toasterllc/MDCBoard/NextPCB-Order/NextPCB-Package-FedEx-Label.pdf

SHIP DATE: 13JUL23

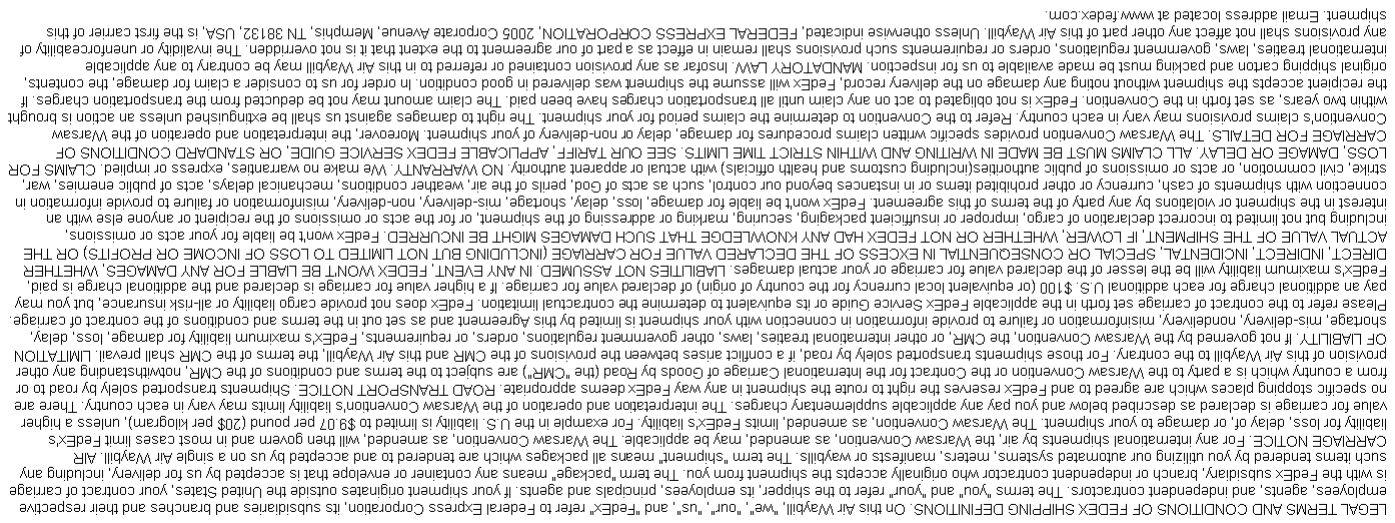
[picture p1: figure]

TO

(CN)

TRK#

ACTWGT: 0.33 KG

DIMS: 16x25x13 CM

REF:

INV:

PO: DEPT:

ORIGIN ID:ZSMA

0430

### (808) 990-3519 DAVID KECK

1200 FRANKLIN MALL

1279

### SANTA CLARA, CA 95050 US SIGN: DAVID KECK

CAD: 258250449/INET4535

BILL SENDER

AES X20230710678266

XIE LIJIA

NEXTPCB

5TH FLOOR,BLOCK A,BUILDING 2,ZONE B

KEGU INDUSTRIAL PARK

### 26 JIAN'AN ROAD

DONGGUAN 523846

8613413077079

# C4 DAXA

7727 2663 9725

PM
INTL CONN PLUS
ETD
523846

## -CN DGM
