toasterllc/MDCBoard/NextPCB-Order/Diodes-Orientation.jpg

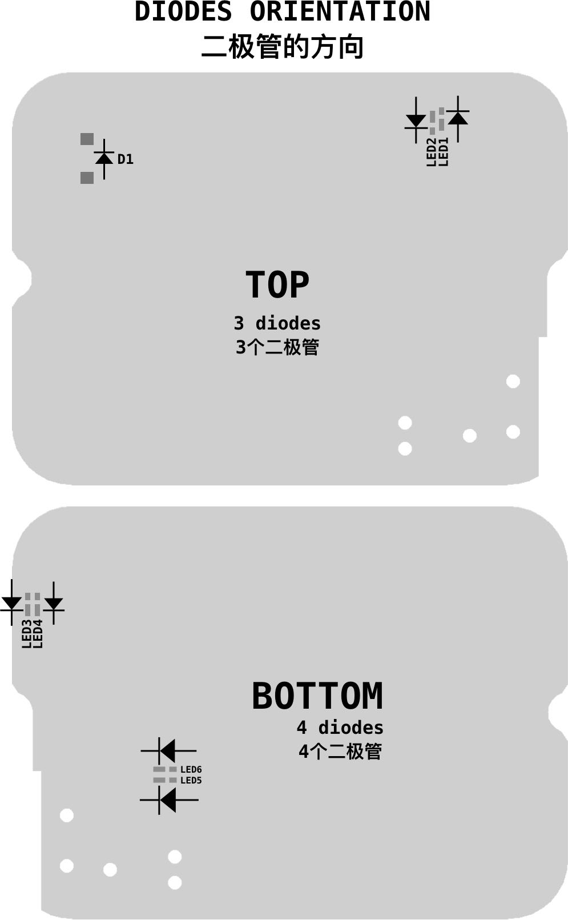
NextPCB-Order/Diodes-Orientation.jpg
