toasterllc/MDCBoard/NextPCB-Order/NextPCB-FedEx-Label.png

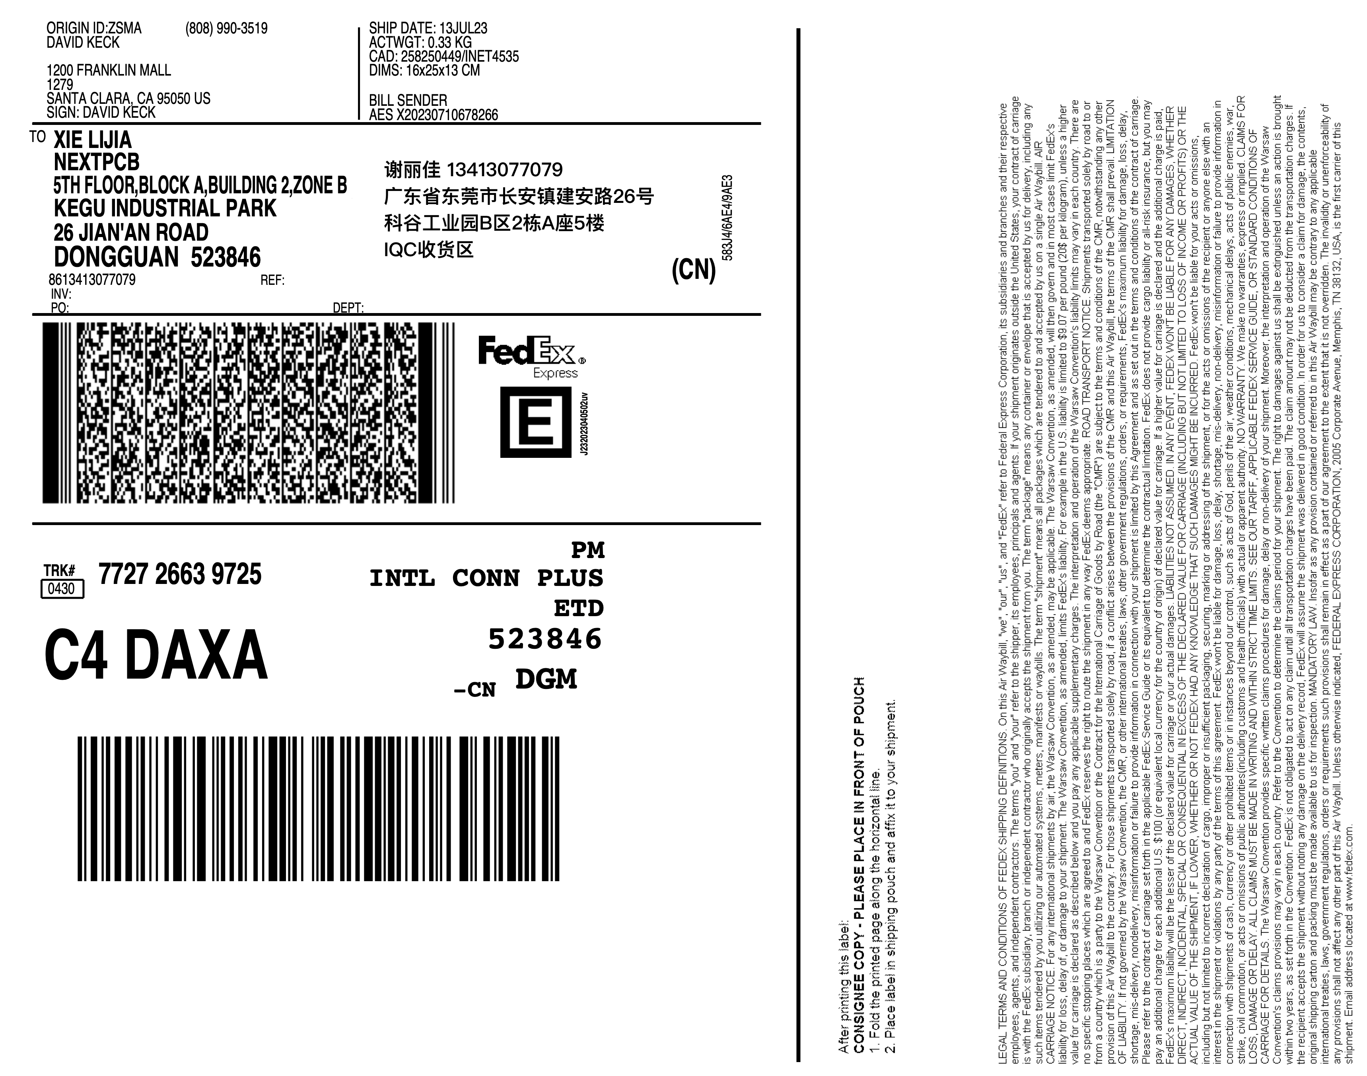
NextPCB-Order/NextPCB-FedEx-Label.png
