toasterllc/MDCBoard/NextPCB-Order/NextPCB-New-Parts.png

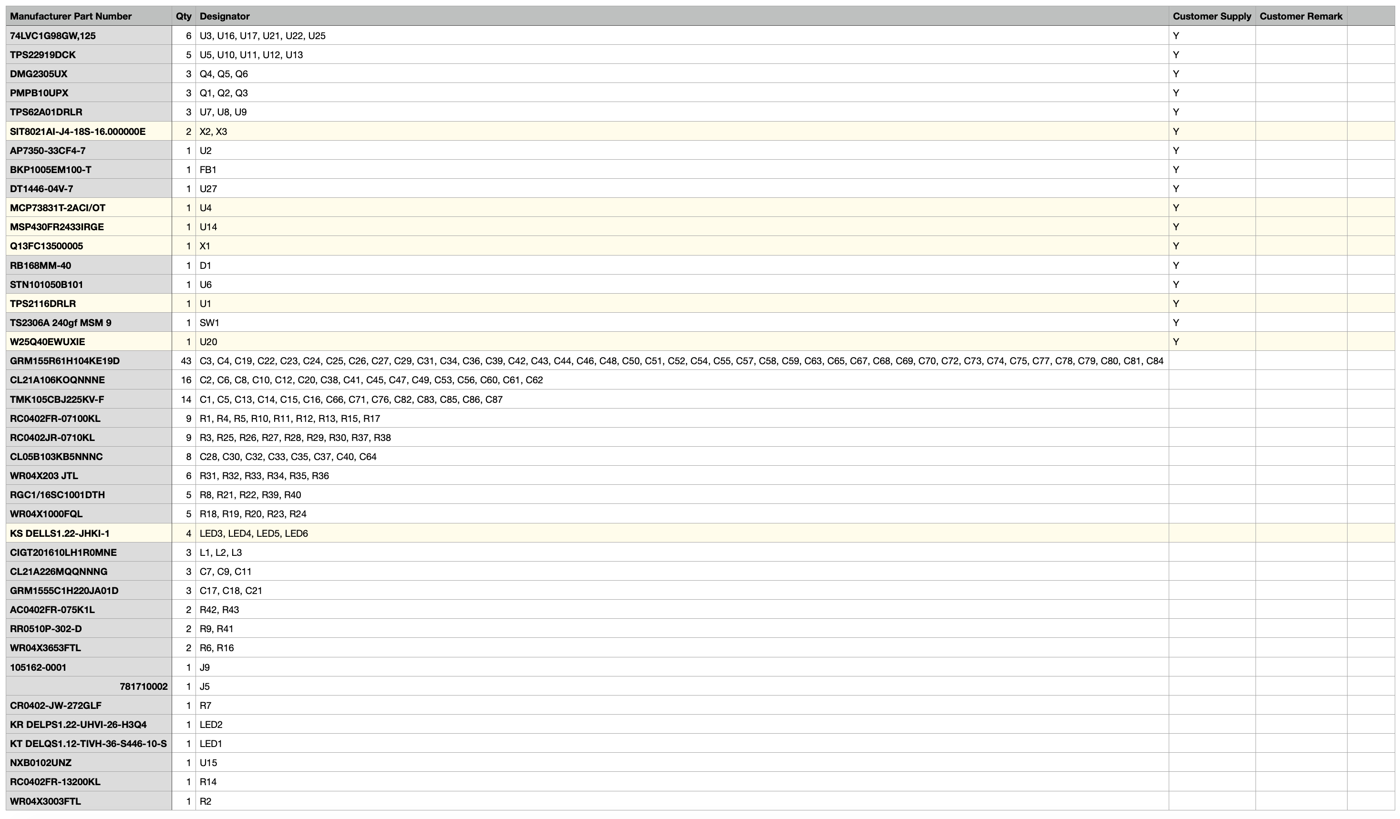
NextPCB-Order/NextPCB-New-Parts.png
