toasterllc/MDCBoard/NextPCB-Order/NextPCB-Package-FedEx-Label.png

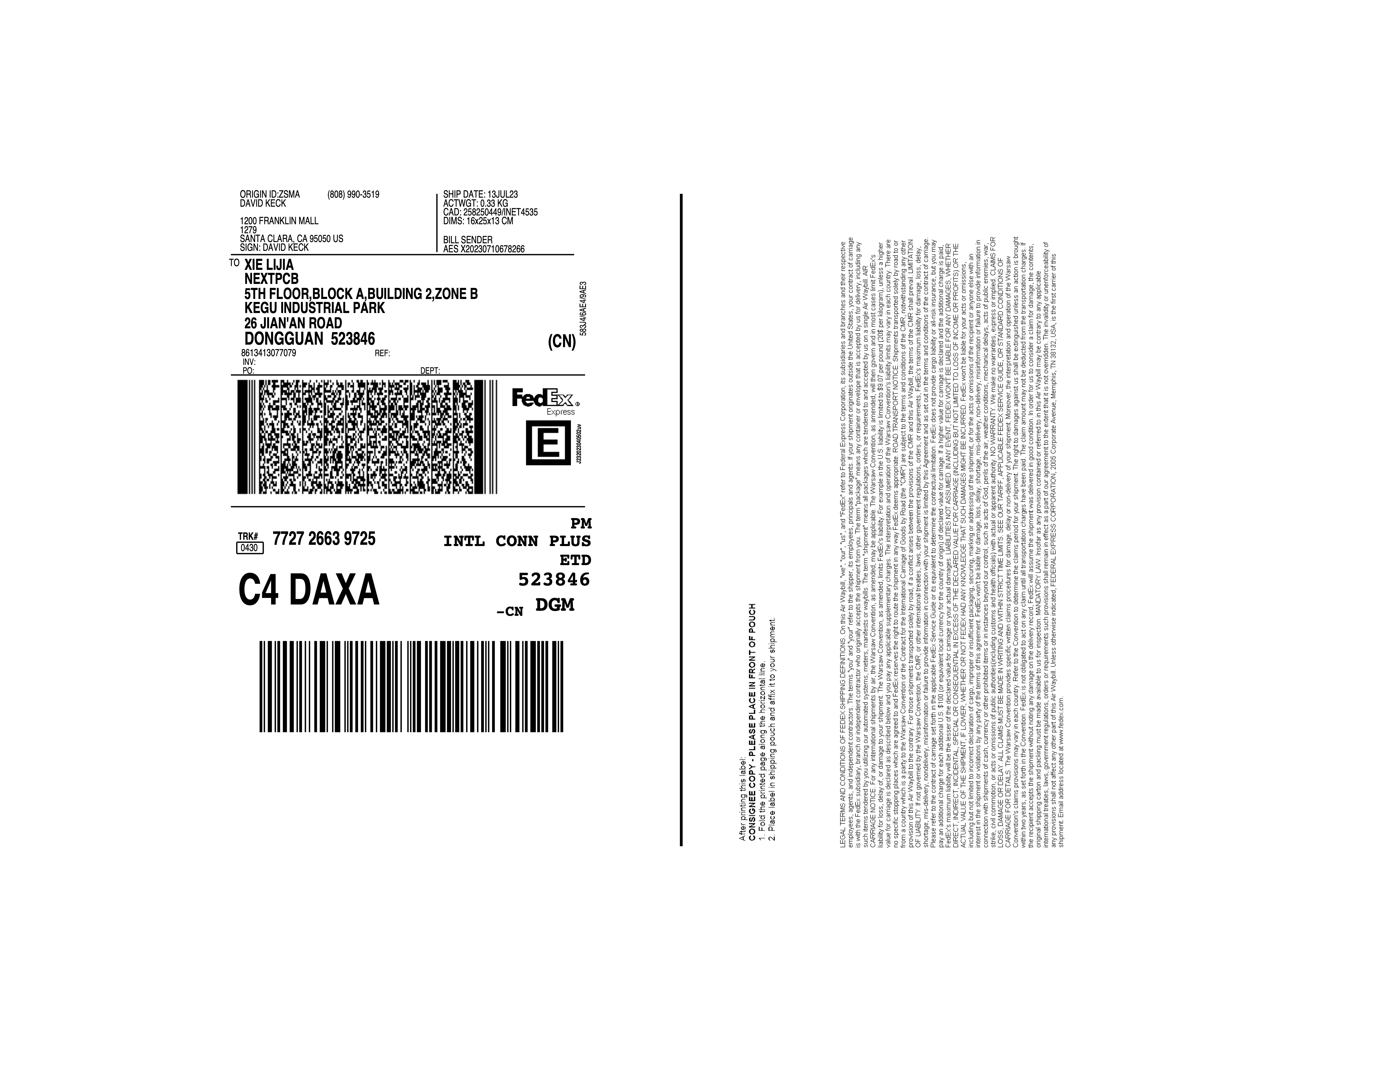
NextPCB-Order/NextPCB-Package-FedEx-Label.png
