toasterllc/MDCBoard/Schematic.pdf

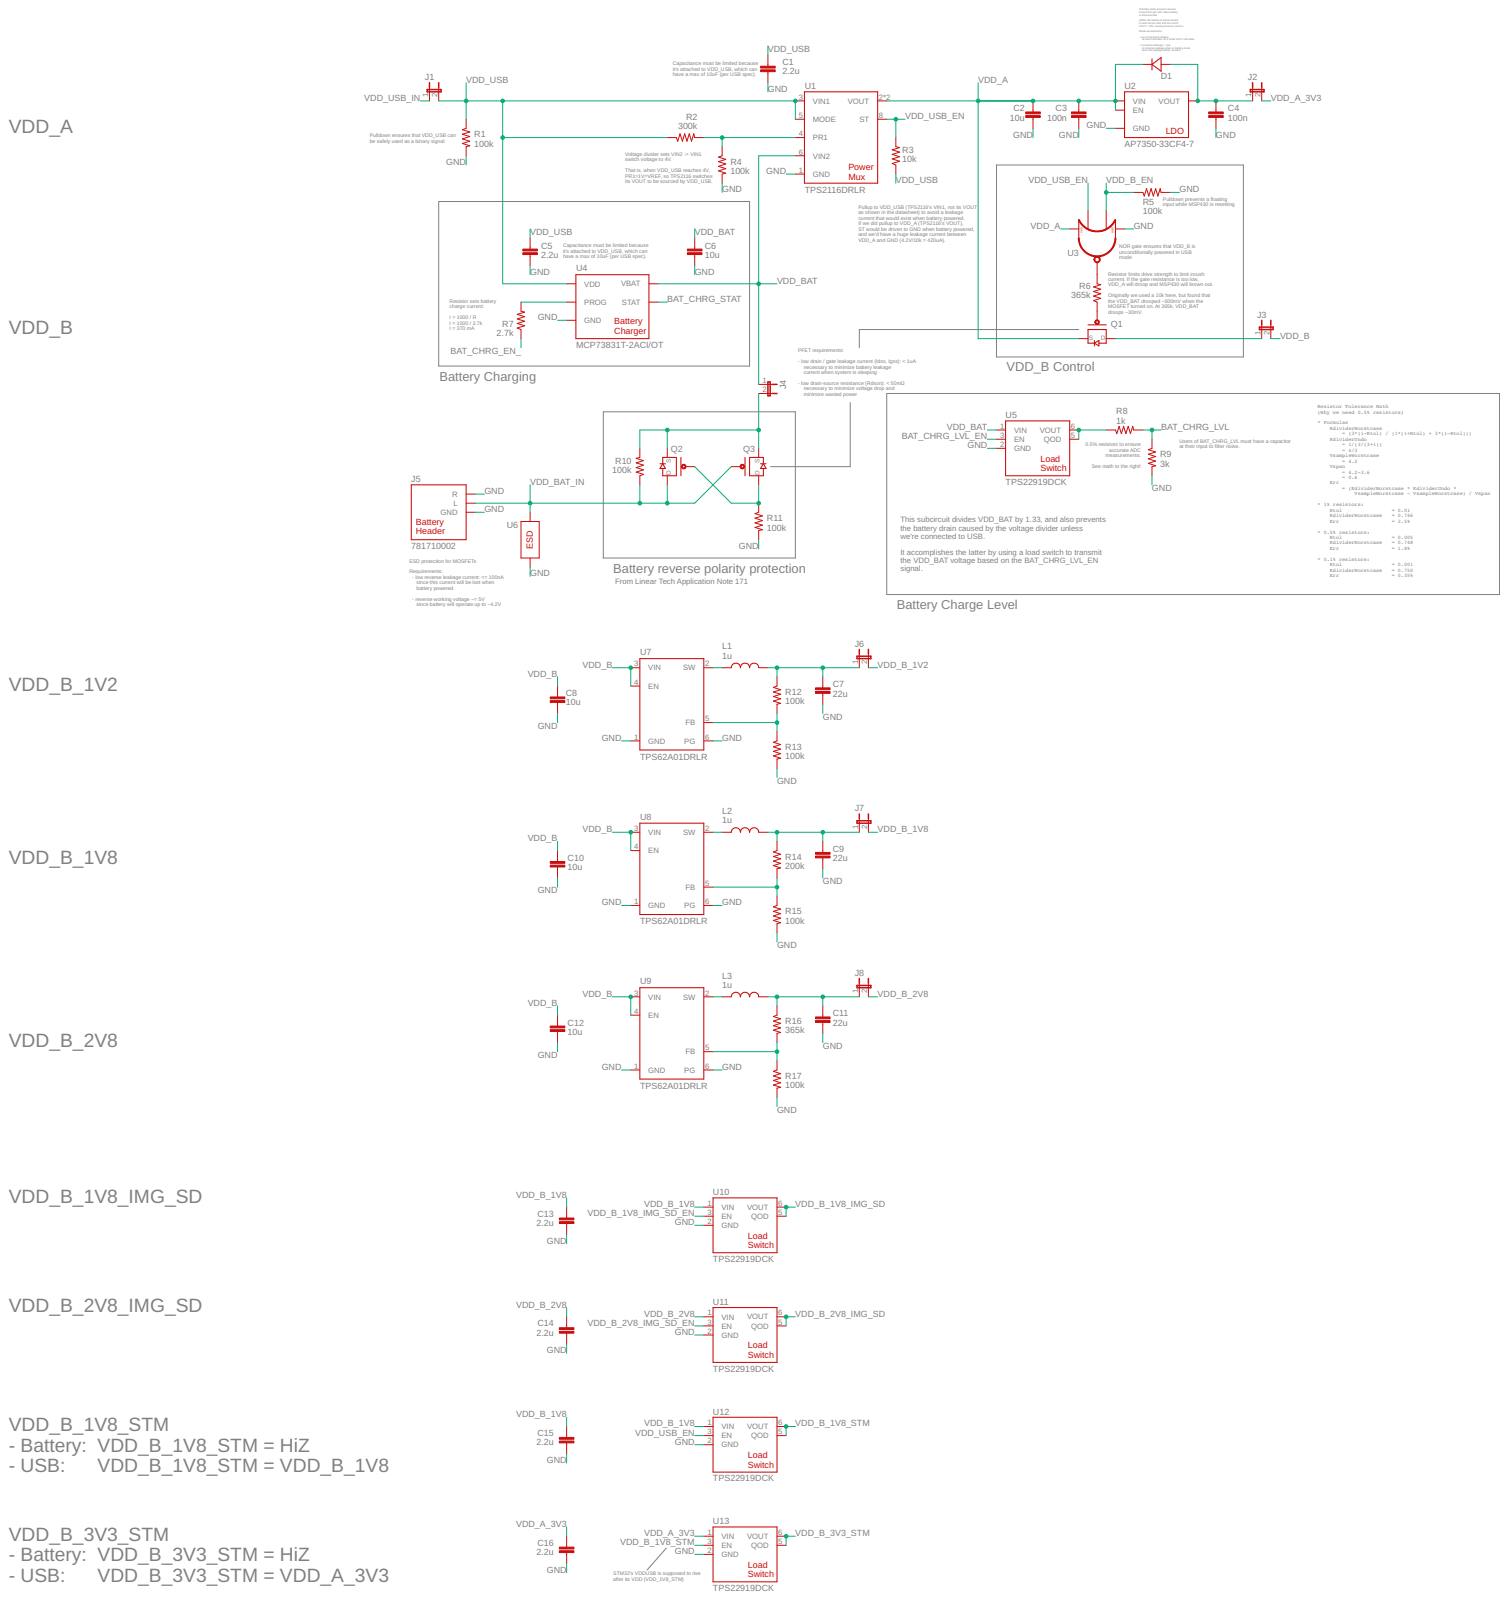
[picture p6: page 1]

Schottky diode prevents reverse
current through LDO when battery
is disconnected. (When the battery is disconnected,

it could be the case that the LDO's VOUT > VIN, causing reverse current.) Diode requirements: - Low Vf (forward voltage) so that it activates on a small VOUT-VIN delta

- Ir (reverse leakage) < 1µA
to minimize leakage when in battery-mode, since this leakage will be constant

Capacitance must be limited because
it's attached to VDD_USB, which can
have a max of 10uF (per USB spec).

Pulldown ensures that VDD_USB can
be safely used as a binary signal

Voltage divider sets VIN2 -> VIN1
switch voltage to 4V. That is, when VDD_USB reaches 4V, PR1=1V=VREF, so TPS2116 switches

its VOUT to be sourced by VDD_USB.

Pullup to VDD_USB (TPS2116's VIN1, not its VOUT
as shown in the datasheet) to avoid a leakage
current that would exist when battery powered.
If we did pullup to VDD_A (TPS2116's VOUT), ST would be driven to GND when battery powered, and we'd have a huge leakage current between VDD_A and GND (4.2V/10k = 420uA).

input while MSP430 is resetting

NOR gate ensures that VDD_B is unconditionally powered in USB mode

Resistor limits drive strength to limit inrush
current. If the gate resistance is too low, VDD_A will droop and MSP430 will brown out. Originally we used a 10k here, but found that

the VDD_BAT drooped ~500mV when the MOSFET turned on. At 365k, VDD_BAT
droops ~30mV.

PFET requirements: - low drain / gate leakage current (Idss, Igss): < 1uA

necessary to minimize battery leakage
current when system is sleeping
- low drain-source resistance (Rdson): < 50mΩ

(Why we need 0.5% resistors)

0.5% resistors to ensure
accurate ADC measurements. See math to the right!

Users of BAT_CHRG_LVL must have a capacitor at their input to filter noise.

This subcircuit divides VDD_BAT by 1.33, and also prevents
the battery drain caused by the voltage divider unless we're connected to USB.

It accomplishes the latter by using a load switch to transmit
the VDD_BAT voltage based on the BAT_CHRG_LVL_EN

signal. ESD protection for MOSFETs Requirements: - low reverse leakage current: <= 100nA

From Linear Tech Application Note 171 Battery reverse polarity protection

since this current will be lost when
battery powered
- reverse working voltage ~= 5V
since battery will operate up to ~4.2V

STM32's VDDUSB is supposed to rise
after its VDD (VDD_1V8_STM)

22p

22p | 22p
100n | 10u
100n | 100n

100n

From "MSP430TM 32-kHz Crystal Oscillators", section "Effective Load Capacitance": Crystal capacitor values are calculated using: C_L = (C + C_para) / 2 Where: C_L = load capacitance from crystal datasheet C = capacitor value to solve for C_para = parasitic capacitance of MSP pin + trace C_para = 2pF (MSP capacitance per pin) + 1 pF (estimated trace capacitance) = 3 pF C_L = 12.5 pF (from crystal datasheet) Therefore, C = 22 pF | Use NP0 dialectric capacitors to minimize

capacitance variation due to temperature and DC bias

MSP_RST_: MSP430 has an internal 20k-50k pullup on MSP_RST_, so we don't add an

external one to save a part. MSP_RST_: The MSP430 datasheet recommends a 1nF capacitor on MSP_RST_, but we don't use

that value anywhere else, so we're opting for a much smaller 22pF. (Note that we can't use a

larger value because it interferes with Spy-bi-wire comms.) Since the recommended 1nF capacitor is for noise suppression, we should be able to get away with a smaller capacitor, and it hasn't caused issues so far.

Use TXB0102's VCCB for our VDD_A because the datasheet says: "VCCA must not exceed VCCB"

Filtering capacitor to filter noise from high-impedance BAT_CHRG_LVL signal.

C21

C17 | C18 C19 | C20 | X1
C23 | C24

C22

## TEST/SBWTCK

2 | RST_/NMI/SBWTDIO
1 | DVCC
24 | DVSS

# 18*3 U14POWER MSP430FR2433IRGE

## PA.0/P1.0/UCB0STE/TA0CLK/A0/VEREF+

7 | | PA.1/P1.1/UCB0CLK/TA0.1/A1
8 | PA.2/P1.2/UCB0SIMO/UCB0SDA/TA0.2/A2/VEREF- 9 | PA.3/P1.3/UCB0SOMI/UCB0SCL/MCLK/A3
10 | | PA.4/P1.4/UCA0TXD/UCA0SIMO/TA1.2/TCK/A4/VREF+
3 | | PA.5/P1.5/UCA0RXD/UCA0SOMI/TA1.1/TMS/A5
4 | | PA.6/P1.6/UCA0CLK/TA1CLK/TDI/TCLK/A6
5 | | PA.7/P1.7/UCA0STE/SMCLK/TDO/A7
6

# U14PORT1 MSP430FR2433IRGE

## PA.8/P2.0/XOUT

21 | | PA.9/P2.1/XIN
22 | | PA.A/P2.2/ACLK
11 | | PA.B/P2.3
13 | | PA.C/P2.4/UCA1CLK
15 | PA.D/P2.5/UCA1RXD/UCA1SOMI 16 | PA.E/P2.6/UCA1TXD/UCA1SIMO
17 | | PA.F/P2.7
19

# U14PORT2 MSP430FR2433IRGE

## PB.0/P3.0

12 | PB.1/P3.1/UCA1STE
14 | PB.2/P3.2

# 20 U14PORT3 MSP430FR2433IRGE

B1 | A1 OE VCCA GND
B2 | A2

## VCCB

# Level Shifter NXB0102UNZ

U15

# VDD_A_3V3

# VDD_A_3V3

# VDD_A_3V3

# VDD_A_3V3 GND

GND | GND GND
GND GND | GND

# GND

GND MSP_TEST MSP_RST_ | MSP_RST_

# ICE_MSP_SPI_DATA_X

# ICE_MSP_SPI_DATA_X

# ICE_MSP_SPI_CLK_X

# ICE_MSP_SPI_CLK_X

# VDD_B_1V8 VDD_B_1V8

# VDD_B_1V8

MSP_XIN MSP_XOUT

# VDD_B_EN

# VDD_B_1V8_IMG_SD_EN

# ICE_MSP_SPI_CLK

# ICE_MSP_SPI_DATA

BAT_CHRG_LVL BAT_CHRG_LVL | BUTTON_SIGNAL_ MOTION_SIGNAL VDD_B_2V8_IMG_SD_EN | MOTION_EN_ MSP_STM_I2C_SDA MSP_STM_I2C_SCL | BAT_CHRG_LVL_EN

# VDD_B_3V3_STM

# LED_SIGNAL

LED_SEL Port 1 | Port 2 | Port 3

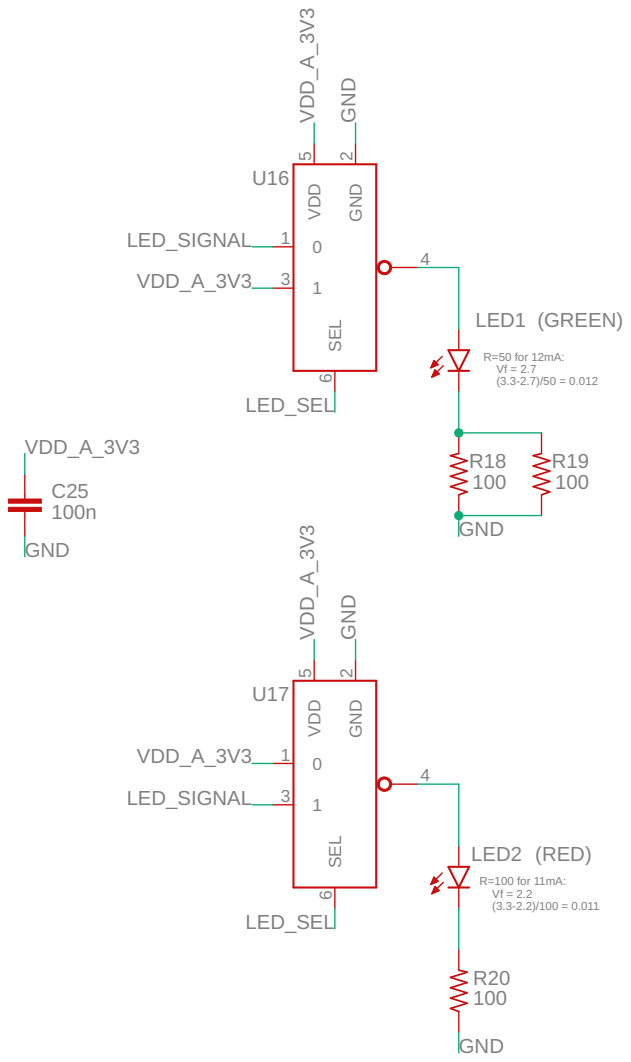
[picture p7: page 3]

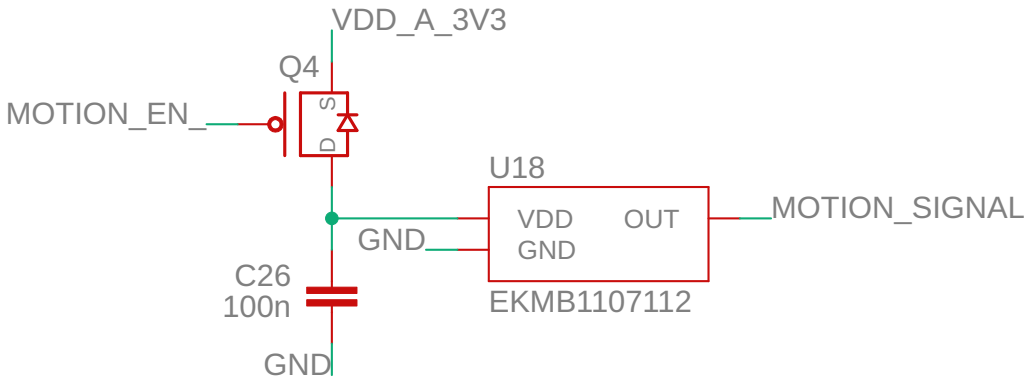
[picture p8: page 5]

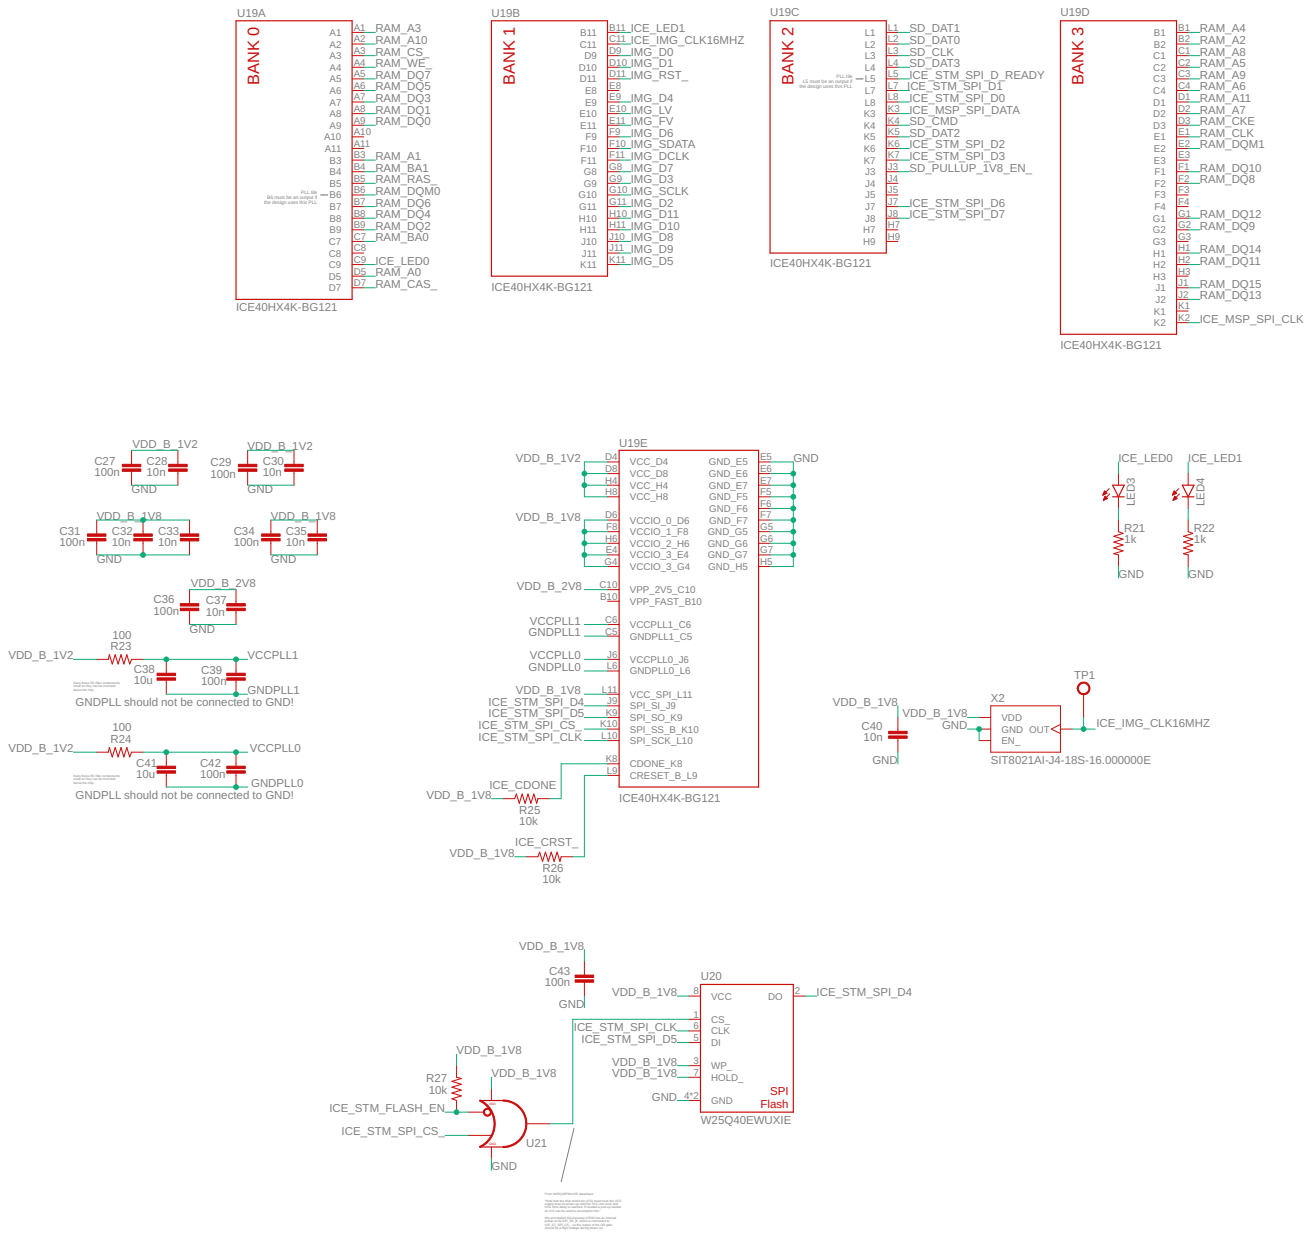
[picture p9: page 6]

L5 must be an output if
the design uses this PLL

PLL tile B6 must be an output if

Keep these RC filter components
small so they can be mounted
below the chip.
GNDPLL should not be connected to GND!

From W25Q40EWUXIE datasheet: "Note that the chip select pin (/CS) must track the VCC

supply level at power-up until the VCC-min level and
tVSL time delay is reached. If needed a pull-up resister on /CS can be used to accomplish this." We accomplish this because ICE40 has an internal pullup on its SPI_SS_B, which is connected to

ICE_ST_SPI_CS_, so the output of the OR gate
should be a high voltage during power up.

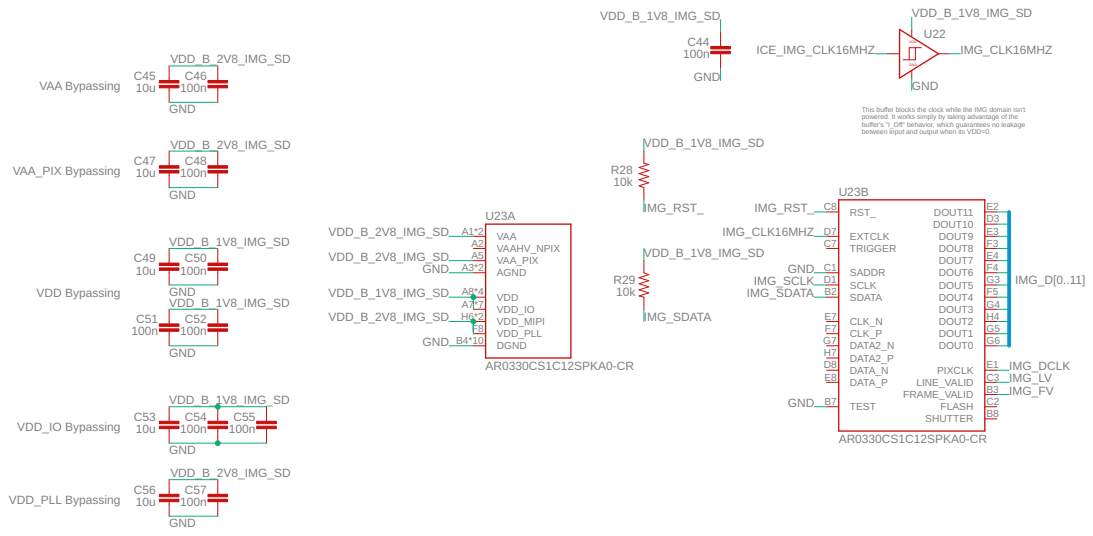
[picture p10: page 7]

This buffer blocks the clock while the IMG domain isn't powered. It works simply by taking advantage of the

buffer's "I_Off" behavior, which guarantees no leakage
between input and output when its VDD=0.

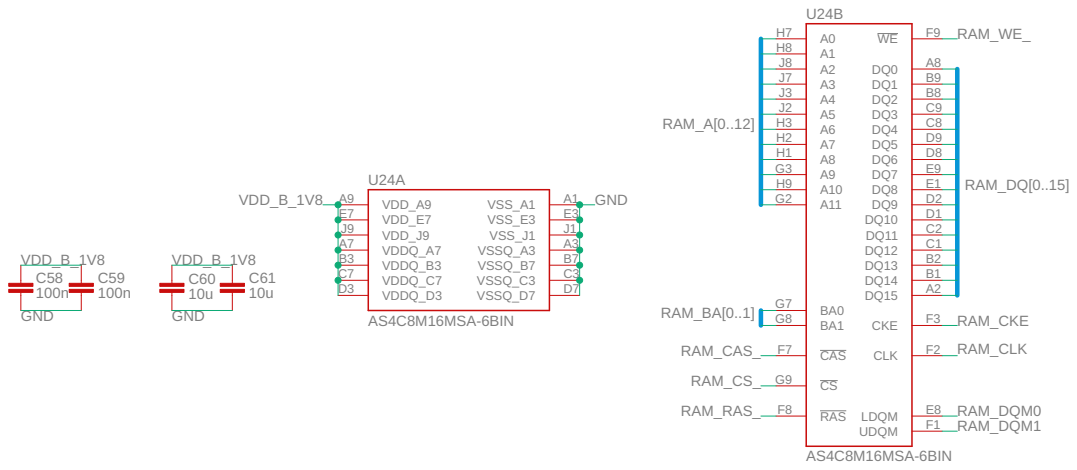
[picture p11: page 8]

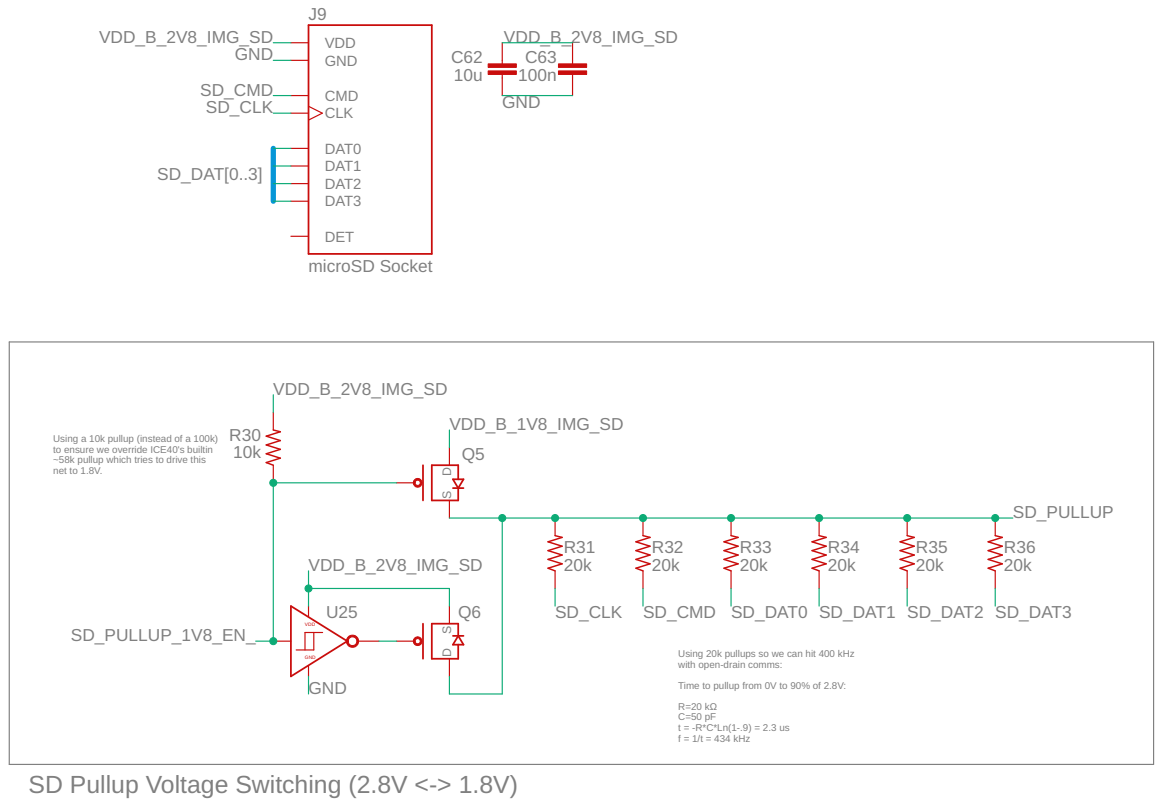
[picture p12: page 9]

Using a 10k pullup (instead of a 100k)
to ensure we override ICE40's builtin ~58k pullup which tries to drive this net to 1.8V.

Using 20k pullups so we can hit 400 kHz with open-drain comms: Time to pullup from 0V to 90% of 2.8V: R=20 kΩ

f = 1/t = 434 kHz SD Pullup Voltage Switching (2.8V <-> 1.8V)

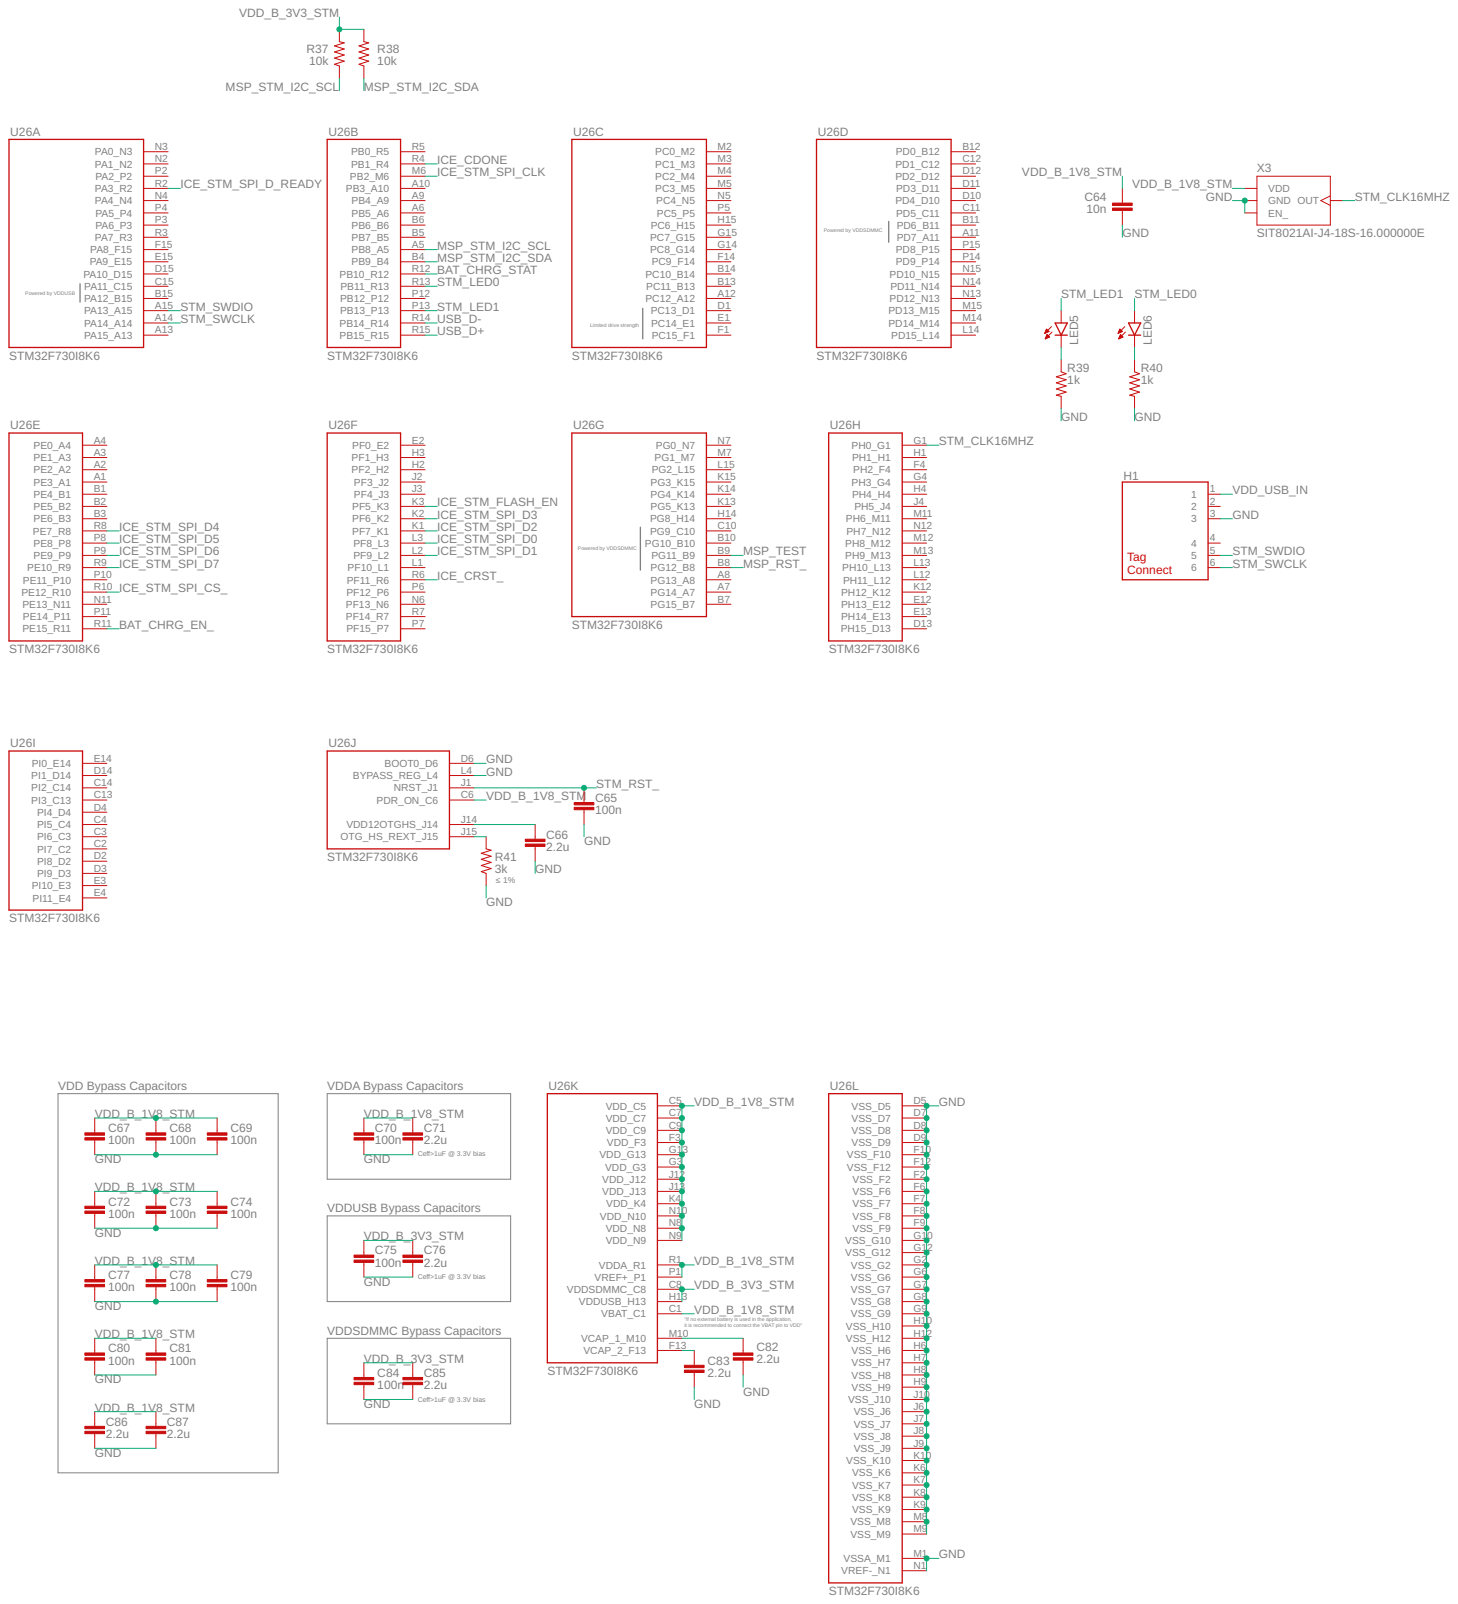
[picture p13: page 10]

it is recommended to connect the VBAT pin to VDD" VDDSDMMC Bypass Capacitors

"If no external battery is used in the application,

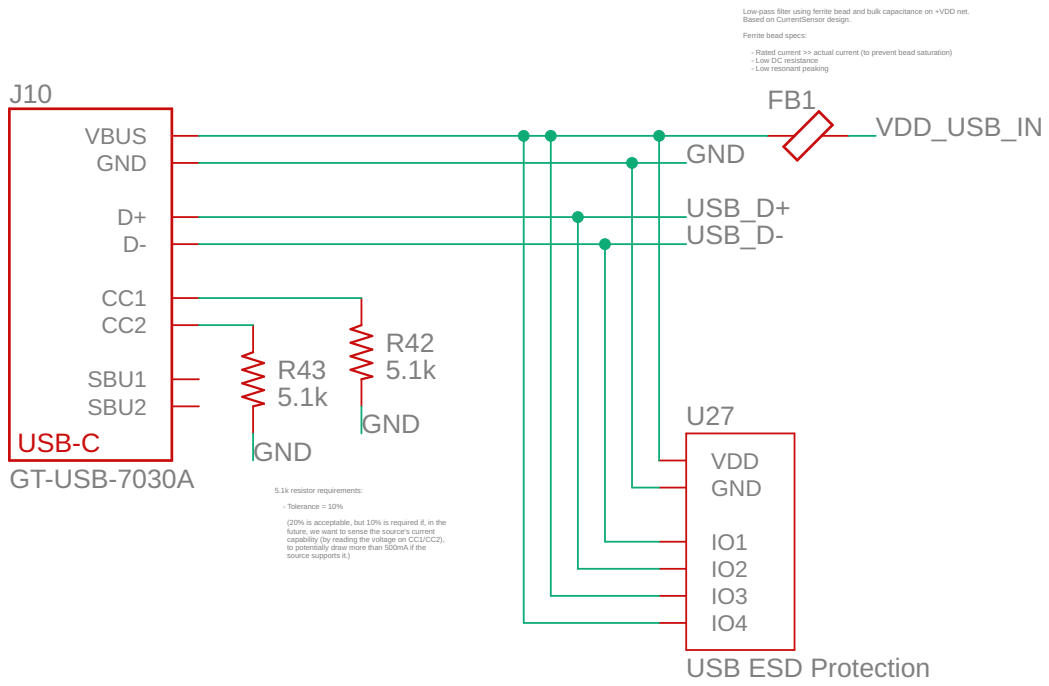
[picture p14: page 11]

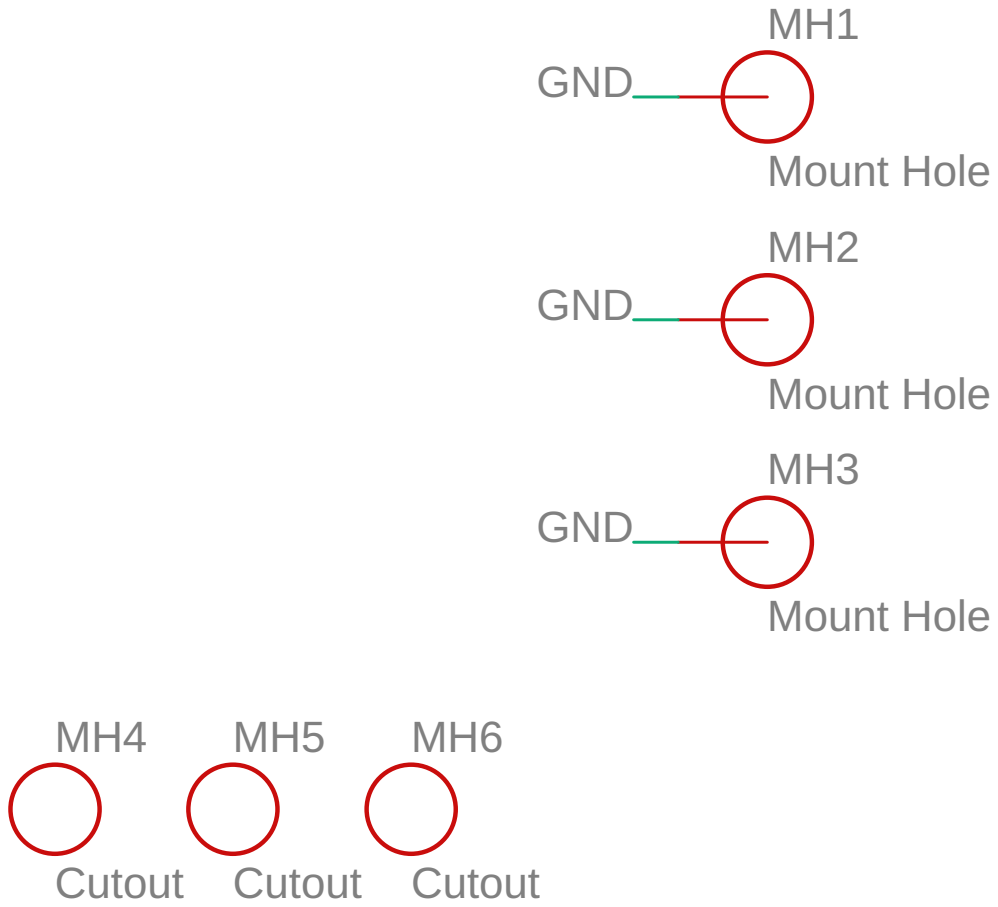
[picture p15: page 12]
