toasterllc/MDCBoard/MDCBoard.brd

## EAGLE design MDCBoard.brd (2023-07-04)

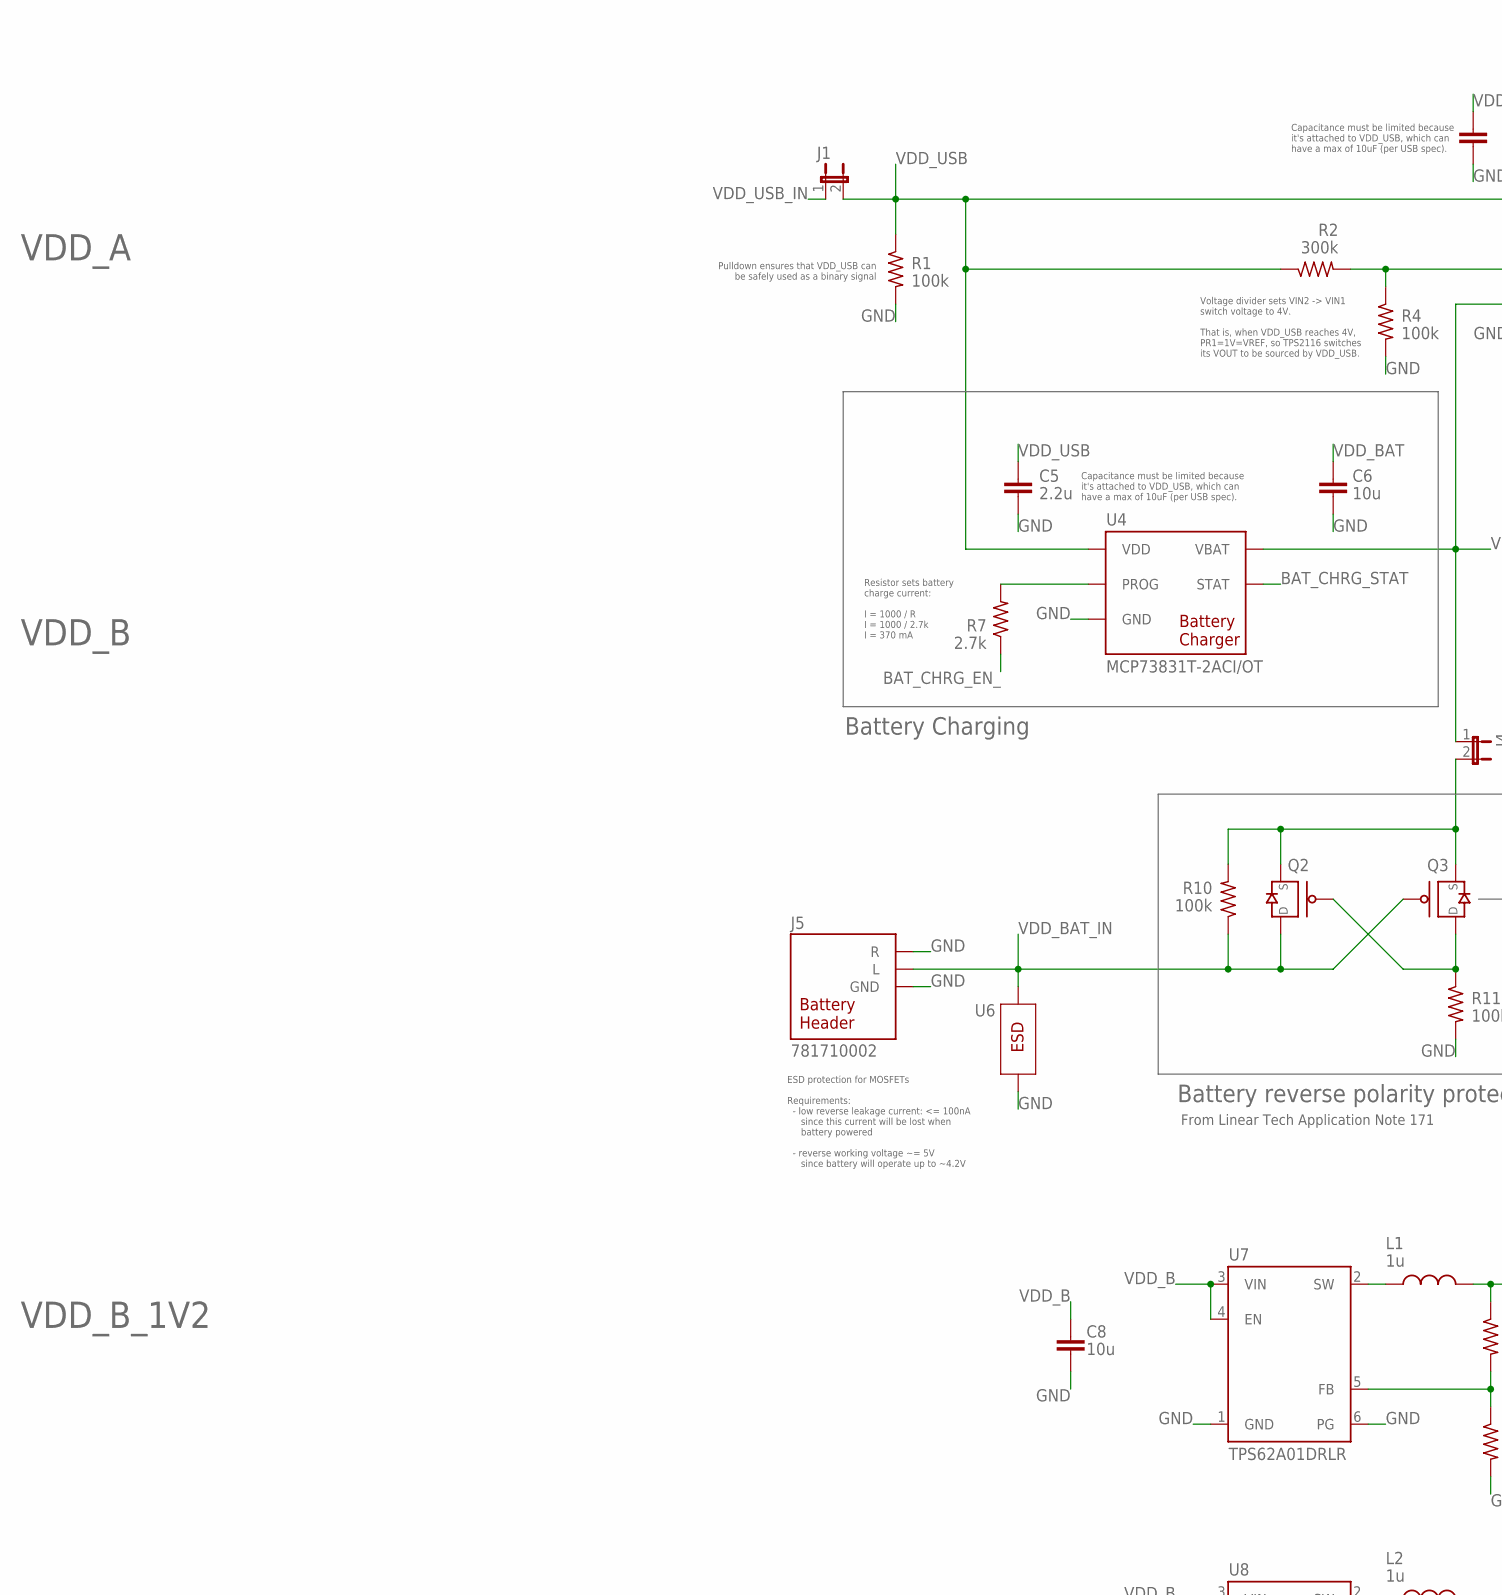
[picture p16: schematic MDCBoard.sch, sheet 1, VDD, part in row 1, column 1]

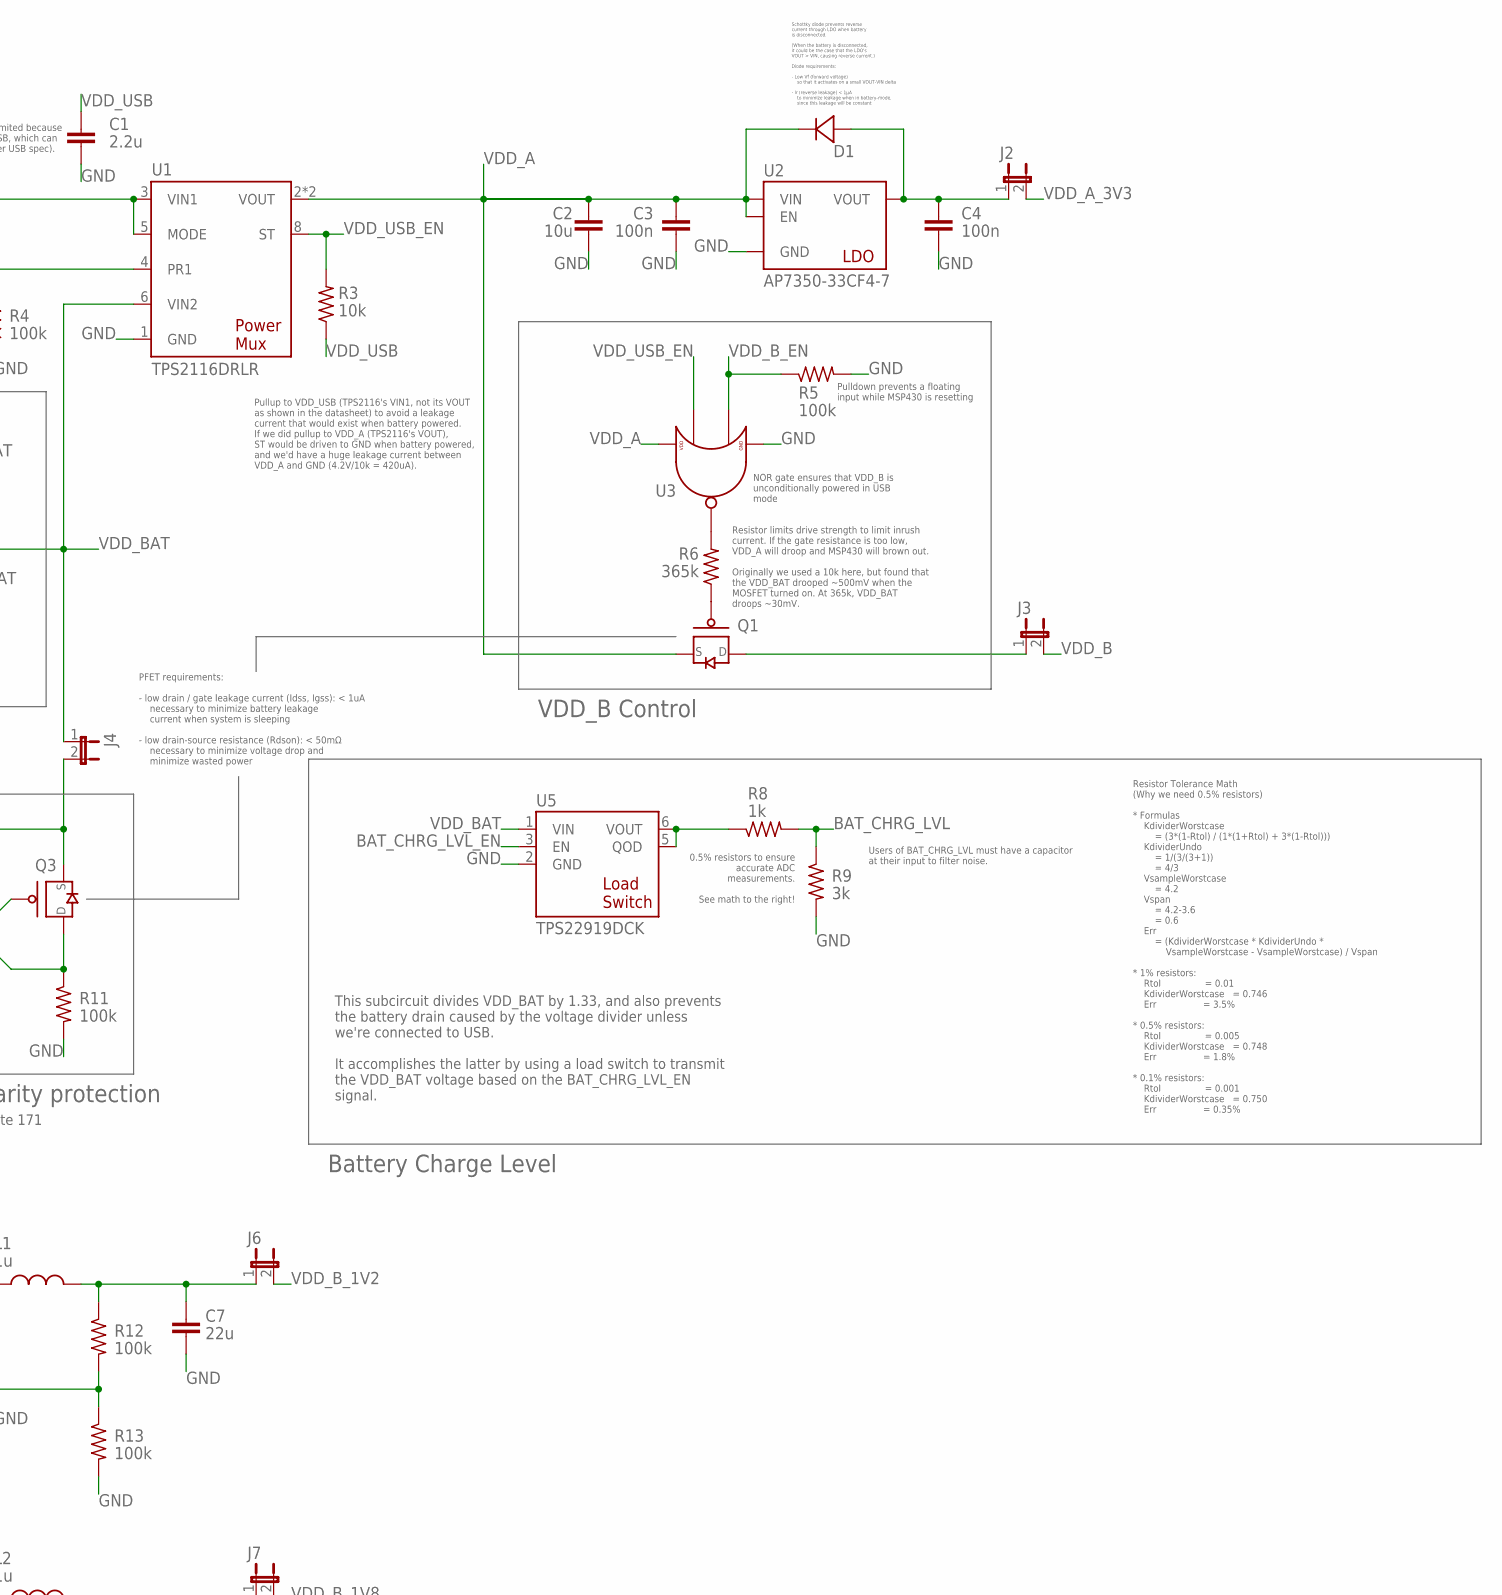
[picture p17: schematic MDCBoard.sch, sheet 1, VDD, part in row 1, column 2]

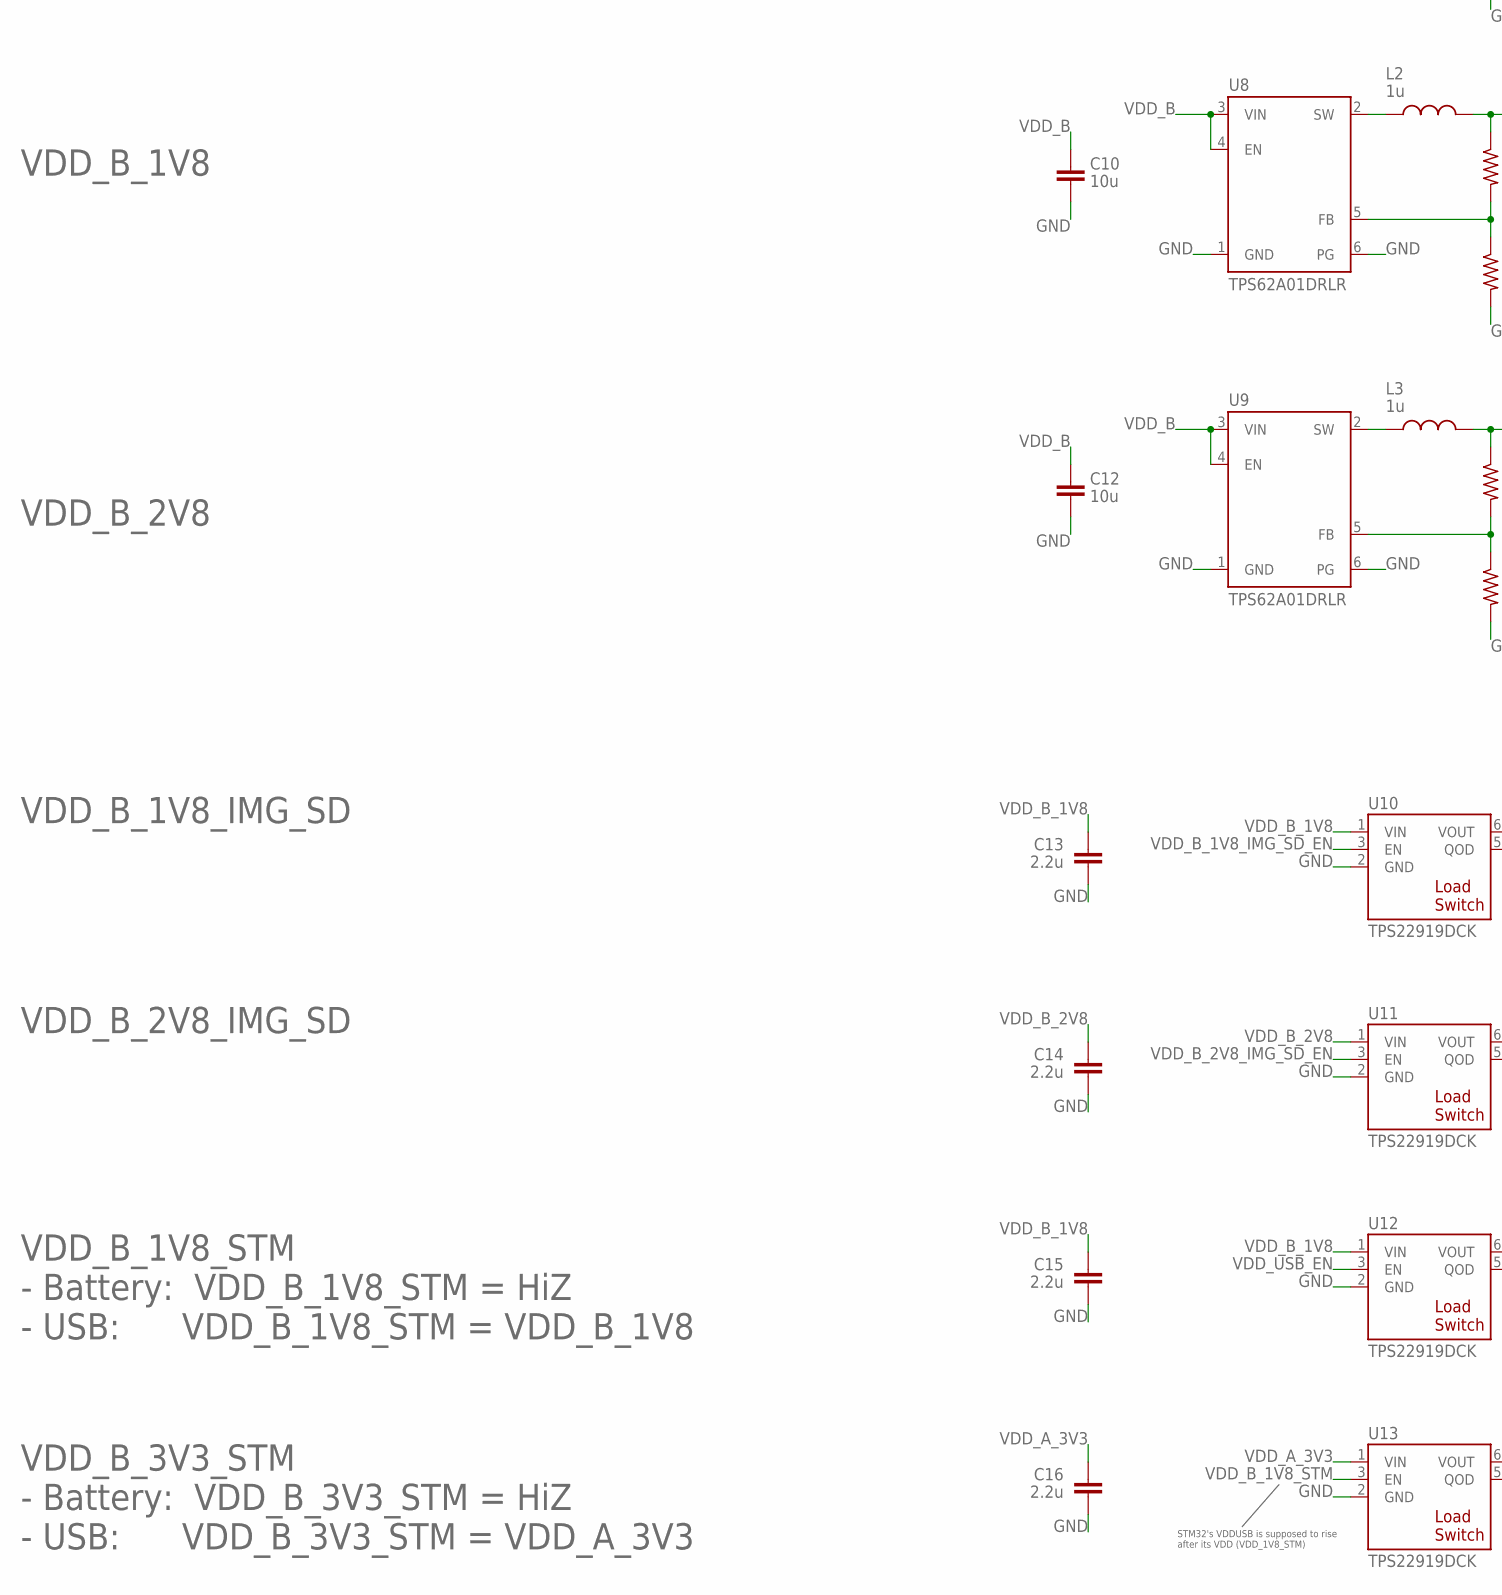
[picture p18: schematic MDCBoard.sch, sheet 1, VDD, part in row 2, column 1]

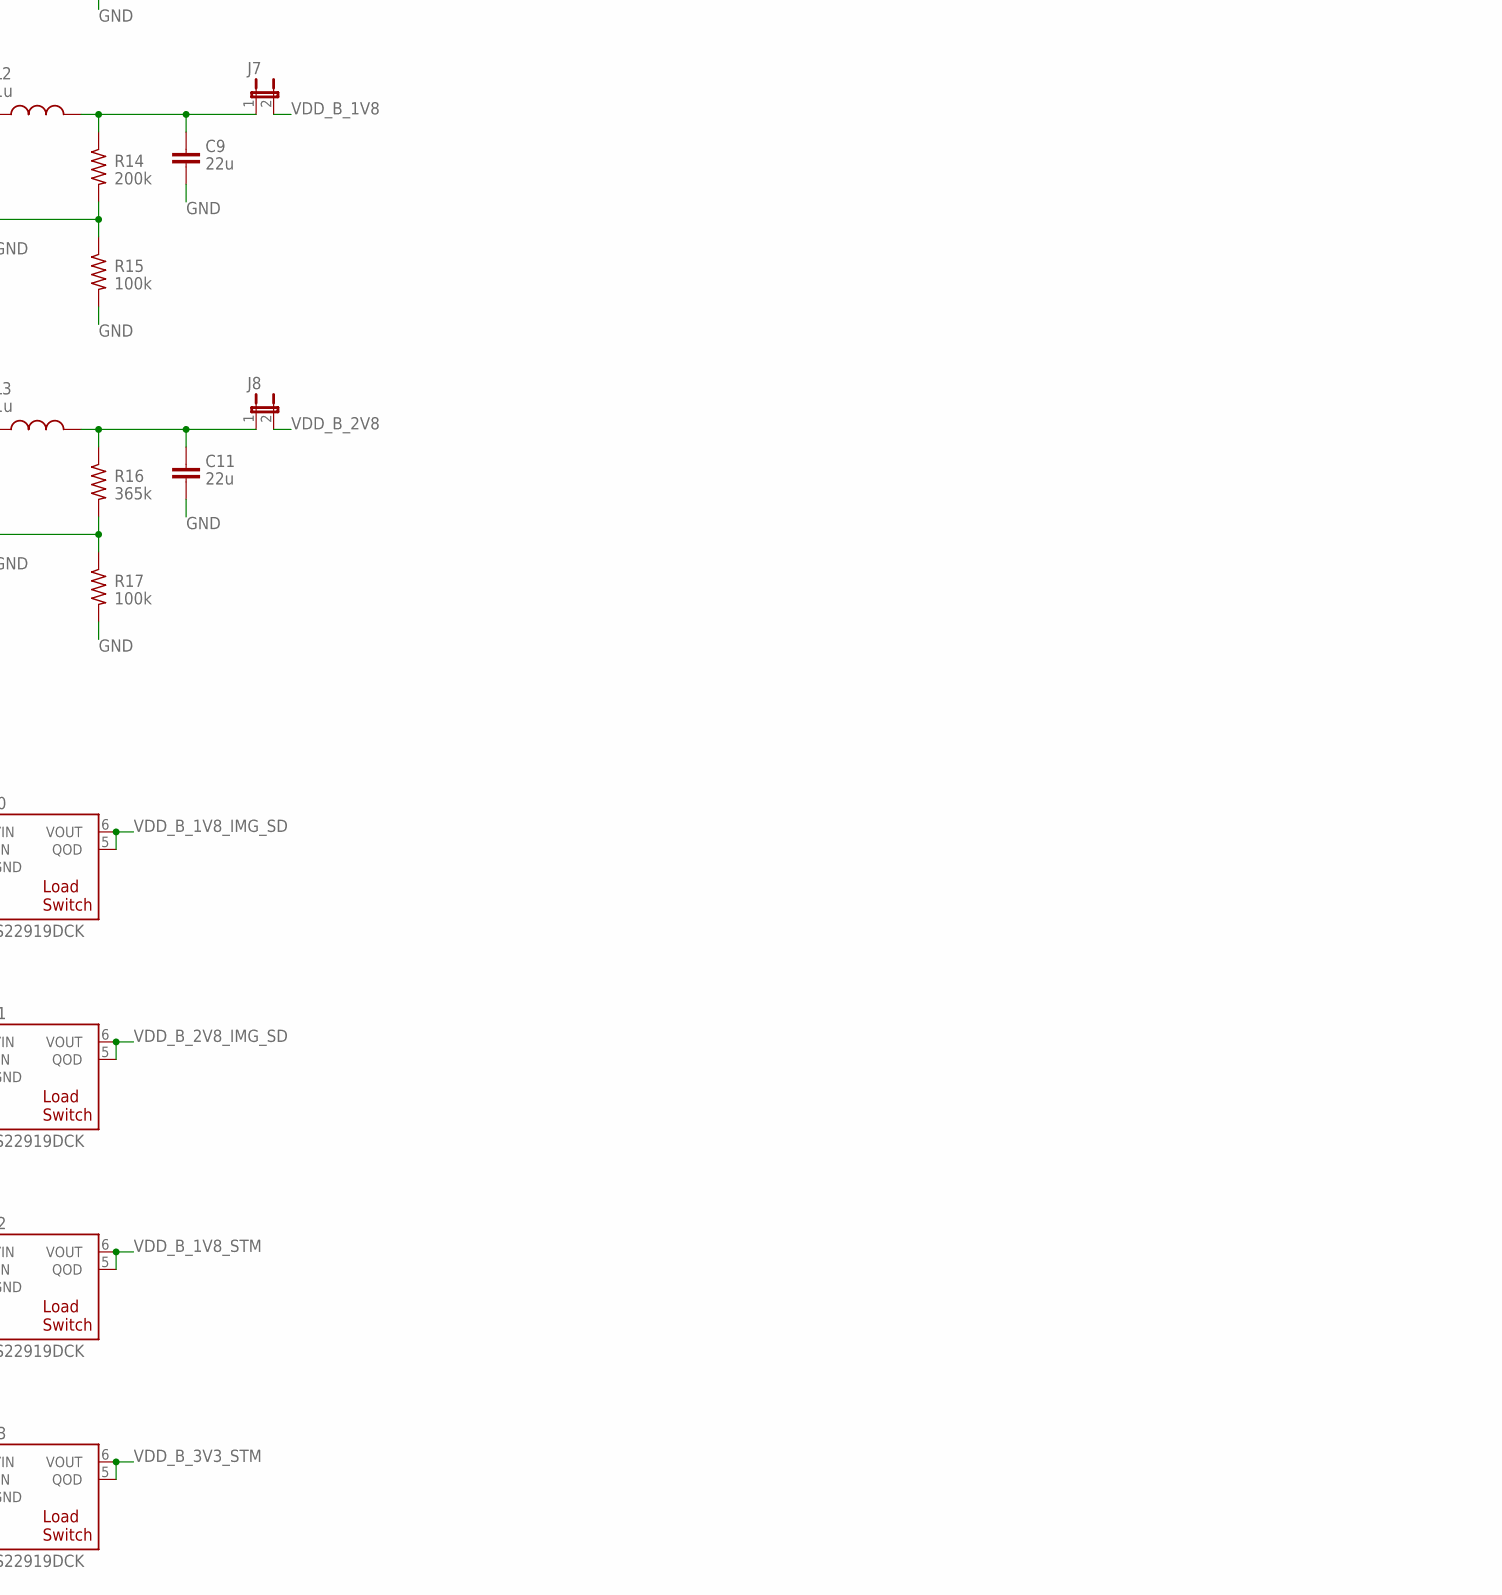
[picture p19: schematic MDCBoard.sch, sheet 1, VDD, part in row 2, column 2]

Parts:
C1, C5, C13, C14, C15, C16: 2.2u; 0402
C2, C6, C8, C10, C12: 10u; 0805
C3, C4: 100n; 0402
C7, C9, C11: 22u; 0805
D1: ROHM-RB168MM-40; ROHM-SOD-123FL
J1, J2, J3, J4, J6, J7, J8: JUMPER-SOLDER-CLOSED
J5: BATTERY-HEADER-MOLEX-781710002; MOLEX-781710002
L1, L2, L3: 1u; 0806
Q1, Q2, Q3: PMOS-NEXPERIA-SOT1220; NEXPERIA-SOT1220
R1, R4, R5, R10, R11, R12, R13, R15, R17: 100k; 0402
R2: 300k; 0402
R3: 10k; 0402
R6, R16: 365k; 0402
R7: 2.7k; 0402
R8: 1k; 0402
R9: 3k; 0402
R14: 200k; 0402
U1: TI-TPS2116; TI-TPS2116DRLR
U2: DIODESINC-AP7350
U3: NEXPERIA-74LVC1G98-NOR; NEXPERIA-SOT363
U4: MICROCHIP-MCP7383X; MICROCHIP-MIC550X-SOT23-5
U5, U10, U11, U12, U13: TI-TPS22919DCK
U6: EATON-STN101
U7, U8, U9: TI-TPS62A01; TI-TPS62A01DRLR

Connections:
BAT_CHRG_EN_: R7.1; also elsewhere on the board
BAT_CHRG_LVL: R8.2, R9.1; also elsewhere on the board
BAT_CHRG_LVL_EN: U5.3 (EN); also elsewhere on the board
BAT_CHRG_STAT: U4.1 (STAT); also elsewhere on the board
GND: C1.2, C2.2, C3.2, C4.2, C5.2, C6.2, C7.2, C8.2, C9.2, C10.2, C11.2, C12.2, C13.2, C14.2, C15.2, C16.2, J5.2 (R), J5.3 (GND), J5.4 (GND), R1.2, R4.2, R5.2, R9.2, R11.2, R13.2, R15.2, R17.2, U1.1 (GND), U2.2 (GND), U3.2 (GND), U4.2 (GND), U5.2 (GND), U6.2, U7.1 (GND), U7.6 (PG), U8.1 (GND), U8.6 (PG), U9.1 (GND), U9.6 (PG), U10.2 (GND), U11.2 (GND), U12.2 (GND), U13.2 (GND); also elsewhere on the board
unnamed: J4.2, Q2.4 (S), Q2.8 (S), Q3.4 (S), Q3.8 (S), R10.2
unnamed: C4.1, D1.A, J2.1, U2.3 (VOUT)
unnamed: Q1.3 (G), R6.1
unnamed: R6.2, U3.4 (OUT)
unnamed: C11.1, J8.1, L3.2, R16.1
unnamed: L2.1, U8.2 (SW)
unnamed: R8.1, U5.5 (QOD), U5.6 (VOUT)
unnamed: R14.2, R15.1, U8.5 (FB)
unnamed: C9.1, J7.1, L2.2, R14.1
unnamed: R7.2, U4.5 (PROG)
unnamed: L3.1, U9.2 (SW)
unnamed: L1.1, U7.2 (SW)
unnamed: Q2.3 (G), Q3.1 (D), Q3.2 (D), Q3.5 (D), Q3.6 (D), Q3.7 (D), R11.1
unnamed: R16.2, R17.1, U9.5 (FB)
unnamed: R12.2, R13.1, U7.5 (FB)
unnamed: C7.1, J6.1, L1.2, R12.1
unnamed: R2.2, R4.1, U1.4 (PR1)
unnamed: J3.1, Q1.1 (D), Q1.2 (D), Q1.5 (D), Q1.6 (D), Q1.7 (D)
VDD_A: C2.1, C3.1, D1.C, Q1.4 (S), Q1.8 (S), U1.2 (VOUT), U1.7 (VOUT), U2.1 (EN), U2.4 (VIN), U3.3 (VDD), U3.5 (VDD)
VDD_A_3V3: C16.1, J2.2, U13.1 (VIN); also elsewhere on the board
VDD_B: C8.1, C10.1, C12.1, J3.2, U7.3 (VIN), U7.4 (EN), U8.3 (VIN), U8.4 (EN), U9.3 (VIN), U9.4 (EN)
VDD_BAT: C6.1, J4.1, U1.6 (VIN2), U4.3 (VBAT), U5.1 (VIN)
VDD_BAT_IN: J5.1 (L), Q2.1 (D), Q2.2 (D), Q2.5 (D), Q2.6 (D), Q2.7 (D), Q3.3 (G), R10.1, U6.1
VDD_B_1V2: J6.2; also elsewhere on the board
VDD_B_1V8: C13.1, C15.1, J7.2, U10.1 (VIN), U12.1 (VIN); also elsewhere on the board
VDD_B_1V8_IMG_SD: U10.5 (QOD), U10.6 (VOUT); also elsewhere on the board
VDD_B_1V8_IMG_SD_EN: U10.3 (EN); also elsewhere on the board
VDD_B_1V8_STM: U12.5 (QOD), U12.6 (VOUT), U13.3 (EN); also elsewhere on the board
VDD_B_2V8: C14.1, J8.2, U11.1 (VIN); also elsewhere on the board
VDD_B_2V8_IMG_SD: U11.5 (QOD), U11.6 (VOUT); also elsewhere on the board
VDD_B_2V8_IMG_SD_EN: U11.3 (EN); also elsewhere on the board
VDD_B_3V3_STM: U13.5 (QOD), U13.6 (VOUT); also elsewhere on the board
VDD_B_EN: R5.1, U3.6 (IN2); also elsewhere on the board
VDD_USB: C1.1, C5.1, J1.2, R1.1, R2.1, R3.1, U1.3 (VIN1), U1.5 (MODE), U4.4 (VDD)
VDD_USB_EN: R3.2, U1.8 (ST), U3.1 (IN1), U12.3 (EN)
VDD_USB_IN: J1.1; also elsewhere on the board

Notes on the sheet:
VDD_B_1V8_STM - Battery: VDD_B_1V8_STM = HiZ - USB: VDD_B_1V8_STM = VDD_B_1V8
VDD_A
VDD_B
VDD_B_1V2
VDD_B_1V8
VDD_B_2V8
VDD_B_1V8_IMG_SD
VDD_B_2V8_IMG_SD
VDD_B_3V3_STM - Battery: VDD_B_3V3_STM = HiZ - USB: VDD_B_3V3_STM = VDD_A_3V3
STM32's VDDUSB is supposed to rise after its VDD (VDD_1V8_STM)
NOR gate ensures that VDD_B is unconditionally powered in USB mode
VDD_B Control
Resistor limits drive strength to limit inrush current. If the gate resistance is too low, VDD_A will droop and MSP430 will brown out. Originally we used a 10k here, but found that the VDD_BAT drooped ~500mV when the MOSFET turned on. At 365k, VDD_BAT droops ~30mV.
From Linear Tech Application Note 171
Battery reverse polarity protection
Resistor sets battery charge current: I = 1000 / R I = 1000 / 2.7k I = 370 mA
Pulldown ensures that VDD_USB can be safely used as a binary signal
Schottky diode prevents reverse current through LDO when battery is disconnected. (When the battery is disconnected, it could be the case that the LDO's VOUT > VIN, causing reverse current.) Diode requirements: - Low Vf (forward voltage) so that it activates on a small VOUT-VIN delta - Ir (reverse 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
Voltage divider sets VIN2 -> VIN1 switch voltage to 4V. That is, when VDD_USB reaches 4V, PR1=1V=VREF, so TPS2116 switches its VOUT to be sourced by VDD_USB.
Capacitance must be limited because it's attached to VDD_USB, which can have a max of 10uF (per USB spec).
Battery Charge Level
Battery Charging
This subcircuit divides VDD_BAT by 1.33, and also prevents the battery drain caused by the voltage divider unless we're connected to USB. It accomplishes the latter by using a load switch to transmit the VDD_BAT voltage based on the BAT_CHRG_LVL_EN signal.
ESD protection for MOSFETs Requirements: - low reverse leakage current: <= 100nA since this current will be lost when battery powered - reverse working voltage ~= 5V since battery will operate up to ~4.2V
Users of BAT_CHRG_LVL must have a capacitor at their input to filter noise.
Pulldown prevents a floating input while MSP430 is resetting
PFET requirements: - low drain / gate leakage current (Idss, Igss): < 1uA necessary to minimize battery leakage current when system is sleeping - low drain-source resistance (Rdson): < 50mΩ necessary to minimize voltage drop and minimize wasted power
Resistor Tolerance Math (Why we need 0.5% resistors) * Formulas KdividerWorstcase = (3*(1-Rtol) / (1*(1+Rtol) + 3*(1-Rtol))) KdividerUndo = 1/(3/(3+1)) = 4/3 VsampleWorstcase = 4.2 Vspan = 4.2-3.6 = 0.6 Err = (KdividerWorstcase * KdividerUndo * VsampleWorstcase - VsampleWorstcase) / Vspan * 1% resi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
0.5% resistors to ensure accurate ADC measurements. See math to the right!
Pullup to VDD_USB (TPS2116's VIN1, not its VOUT as shown in the datasheet) to avoid a leakage current that would exist when battery powered. If we did pullup to VDD_A (TPS2116's VOUT), ST would be driven to GND when battery powered, and we'd have a huge leakage current between VDD_A and GND (4.2V/1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

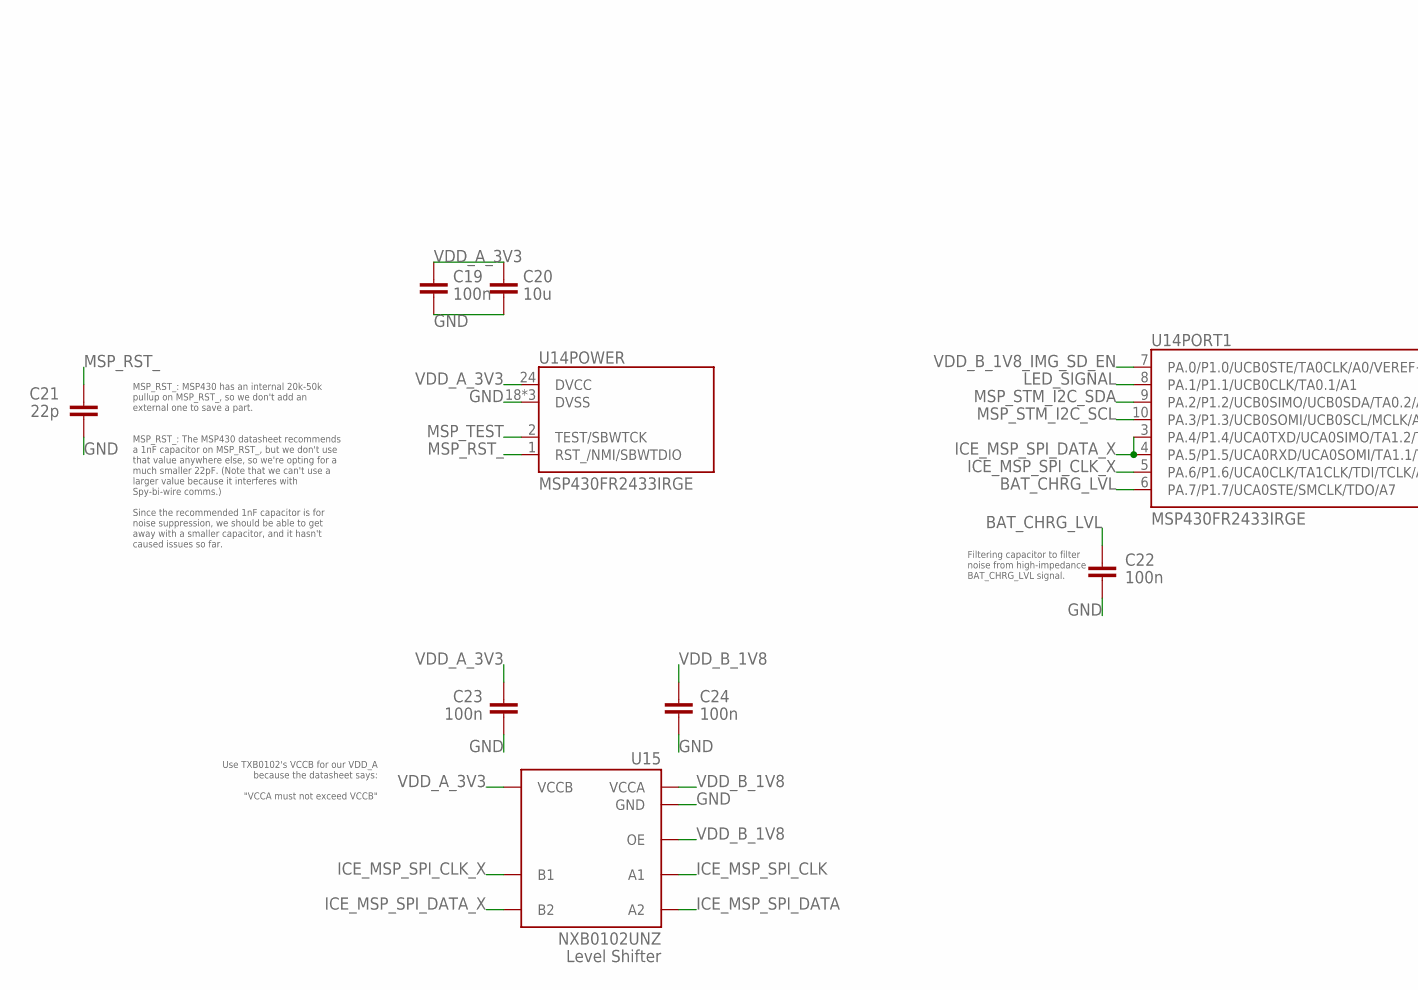
[picture p20: schematic MDCBoard.sch, sheet 2, MSP, part in row 1, column 1]

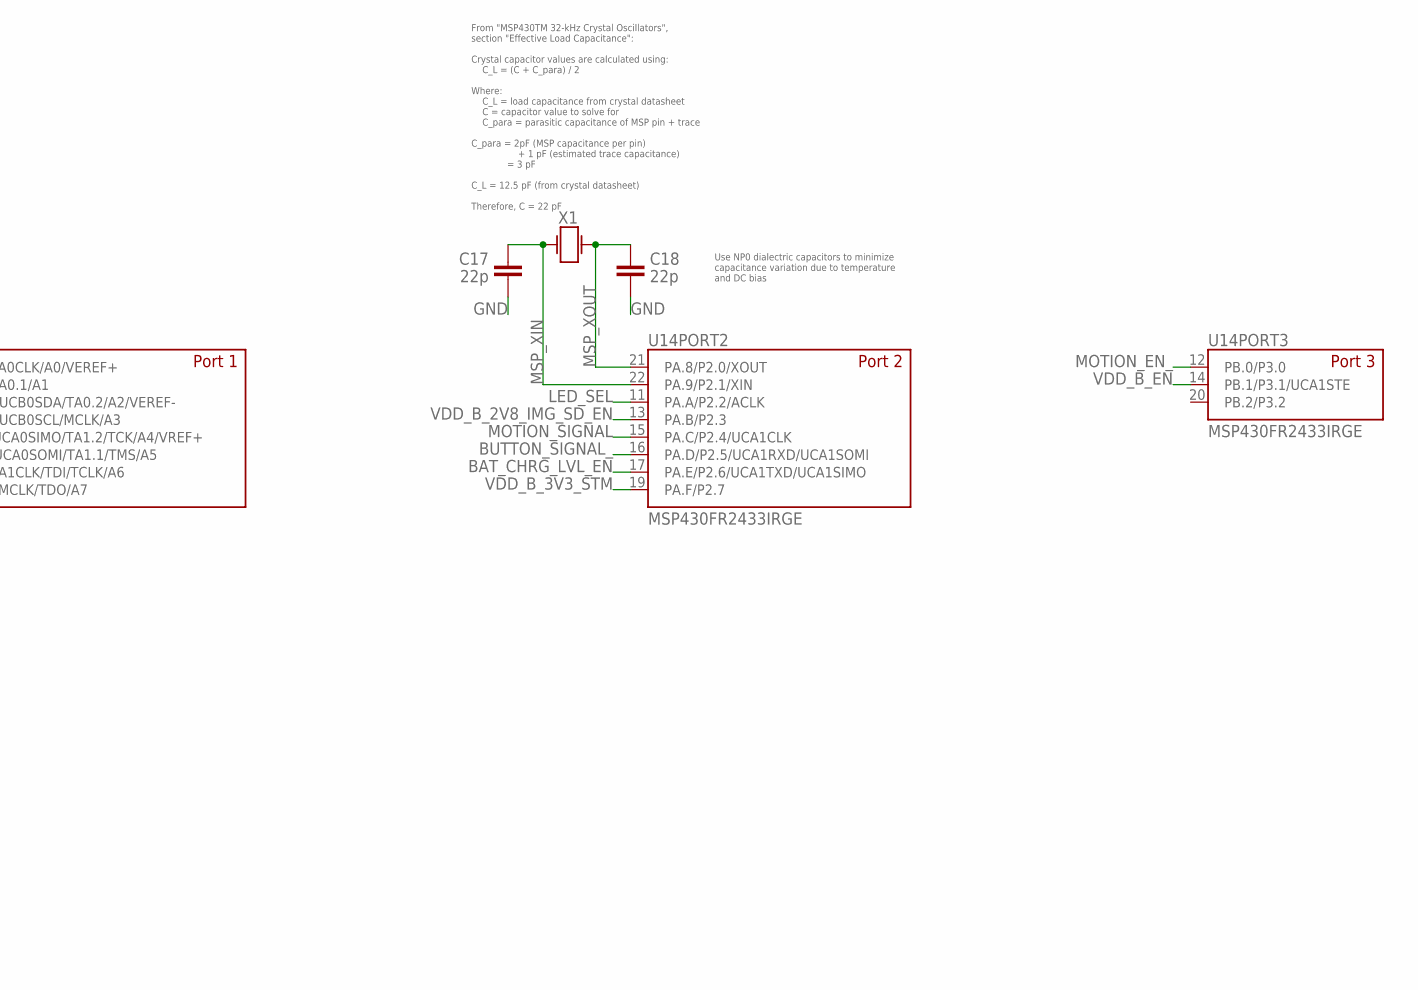
[picture p21: schematic MDCBoard.sch, sheet 2, MSP, part in row 1, column 2]

Parts:
C17, C18, C21: 22p; 0402
C19, C22, C23, C24: 100n; 0402
C20: 10u; 0805
U14: TI-MSP430FR2433IRGE
U15: NEXPERIA-NXB0102; NEXPERIA-NXB0102UN
X1: EPSON-FC-135

Connections:
BAT_CHRG_LVL: C22.1, U14.6 (PA.7/P1.7/UCA0STE/SMCLK/TDO/A7); also elsewhere on the board
BAT_CHRG_LVL_EN: U14.17 (PA.E/P2.6/UCA1TXD/UCA1SIMO); also elsewhere on the board
BUTTON_SIGNAL_: U14.16 (PA.D/P2.5/UCA1RXD/UCA1SOMI); also elsewhere on the board
GND: C17.2, C18.2, C19.2, C20.2, C21.2, C22.2, C23.2, C24.2, U14.18 (DVSS), U14.23 (DVSS), U14.25 (DVSS), U15.B1 (GND); also elsewhere on the board
ICE_MSP_SPI_CLK: U15.D2 (A1); also elsewhere on the board
ICE_MSP_SPI_CLK_X: U14.5 (PA.6/P1.6/UCA0CLK/TA1CLK/TDI/TCLK/A6), U15.A2 (B1)
ICE_MSP_SPI_DATA: U15.D1 (A2); also elsewhere on the board
ICE_MSP_SPI_DATA_X: U14.3 (PA.4/P1.4/UCA0TXD/UCA0SIMO/TA1.2/TCK/A4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), U14.4 (PA.5/P1.5/UCA0RXD/UCA0SOMI/TA1.1/TMS/A5), U15.A1 (B2)
LED_SEL: U14.11 (PA.A/P2.2/ACLK); also elsewhere on the board
LED_SIGNAL: U14.8 (PA.1/P1.1/UCB0CLK/TA0.1/A1); also elsewhere on the board
MOTION_EN_: U14.12 (PB.0/P3.0); also elsewhere on the board
MOTION_SIGNAL: U14.15 (PA.C/P2.4/UCA1CLK); also elsewhere on the board
MSP_RST_: C21.1, U14.1 (RST_/NMI/SBWTDIO); also elsewhere on the board
MSP_STM_I2C_SCL: U14.10 (PA.3/P1.3/UCB0SOMI/UCB0SCL/MCLK/A3); also elsewhere on the board
MSP_STM_I2C_SDA: U14.9 (PA.2/P1.2/UCB0SIMO/UCB0SDA/TA0.2/A2/VER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); also elsewhere on the board
MSP_TEST: U14.2 (TEST/SBWTCK); also elsewhere on the board
MSP_XIN: C17.1, U14.22 (PA.9/P2.1/XIN), X1.2 (B)
MSP_XOUT: C18.1, U14.21 (PA.8/P2.0/XOUT), X1.1 (A)
VDD_A_3V3: C19.1, C20.1, C23.1, U14.24 (DVCC), U15.B2 (VCCB); also elsewhere on the board
VDD_B_1V8: C24.1, U15.C1 (VCCA), U15.C2 (OE); also elsewhere on the board
VDD_B_1V8_IMG_SD_EN: U14.7 (PA.0/P1.0/UCB0STE/TA0CLK/A0/VEREF+); also elsewhere on the board
VDD_B_2V8_IMG_SD_EN: U14.13 (PA.B/P2.3); also elsewhere on the board
VDD_B_3V3_STM: U14.19 (PA.F/P2.7); also elsewhere on the board
VDD_B_EN: U14.14 (PB.1/P3.1/UCA1STE); also elsewhere on the board

Notes on the sheet:
From "MSP430TM 32-kHz Crystal Oscillators", section "Effective Load Capacitance": Crystal capacitor values are calculated using: C_L = (C + C_para) / 2 Where: C_L = load capacitance from crystal datasheet C = capacitor value to solve for C_para = parasitic capacitance of MSP pin + trace C_para = 2p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
Use NP0 dialectric capacitors to minimize capacitance variation due to temperature and DC bias
MSP_RST_: MSP430 has an internal 20k-50k pullup on MSP_RST_, so we don't add an external one to save a part.
MSP_RST_: The MSP430 datasheet recommends a 1nF capacitor on MSP_RST_, but we don't use that value anywhere else, so we're opting for a much smaller 22pF. (Note that we can't use a larger value because it interferes with Spy-bi-wire comms.) Since the recommended 1nF capacitor is for noise suppressi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
Use TXB0102's VCCB for our VDD_A because the datasheet says: "VCCA must not exceed VCCB"
Filtering capacitor to filter noise from high-impedance BAT_CHRG_LVL signal.

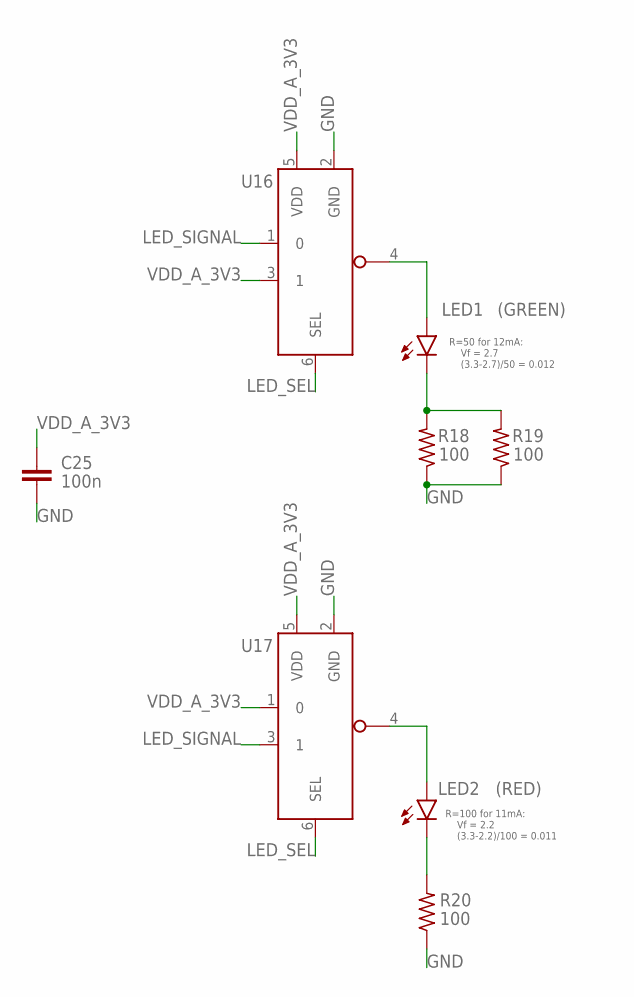
[picture p22: schematic MDCBoard.sch, sheet 3, LED]

Parts:
C25: 100n; 0402
LED1, LED2: LEDOSRAM-TOPLED-E1608; OSRAM-TOPLED-E1608
R18, R19, R20: 100; 0402
U16, U17: NEXPERIA-74LVC1G98-MUX-INV-OUTPUT; NEXPERIA-SOT363

Connections:
GND: C25.2, R18.1, R19.1, R20.1, U16.2 (GND), U17.2 (GND); also elsewhere on the board
LED_SEL: U16.6 (SEL), U17.6 (SEL); also elsewhere on the board
LED_SIGNAL: U16.1 (0), U17.3 (1); also elsewhere on the board
unnamed: LED1.A, U16.4 (OUT)
unnamed: LED2.A, U17.4 (OUT)
unnamed: LED2.C, R20.2
unnamed: LED1.C, R18.2, R19.2
VDD_A_3V3: C25.1, U16.3 (1), U16.5 (VDD), U17.1 (0), U17.5 (VDD); also elsewhere on the board

Notes on the sheet:
R=100 for 11mA: Vf = 2.2 (3.3-2.2)/100 = 0.011
R=50 for 12mA: Vf = 2.7 (3.3-2.7)/50 = 0.012
(GREEN)
(RED)

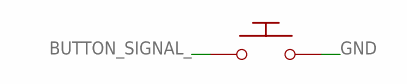
[picture p23: schematic MDCBoard.sch, sheet 4, BUTTON]

Parts:
SW1: TACTILE-SWITCH; DEALON-TD-1624UR-180

Connections:
BUTTON_SIGNAL_: SW1.1; also elsewhere on the board
GND: SW1.2; also elsewhere on the board

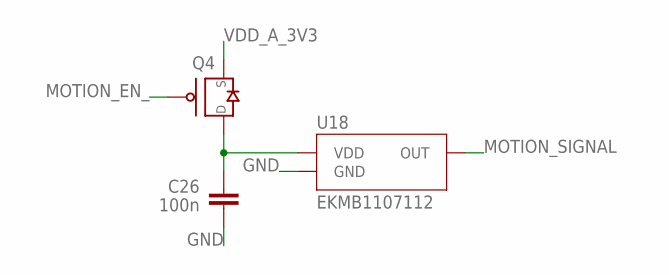
[picture p24: schematic MDCBoard.sch, sheet 5, MOTION]

Parts:
C26: 100n; 0402
Q4: DIODESINC-DMG2305UX
U18: PANASONIC-EKMB110711X

Connections:
GND: C26.2, U18.3 (GND); also elsewhere on the board
MOTION_EN_: Q4.G; also elsewhere on the board
MOTION_SIGNAL: U18.2 (OUT); also elsewhere on the board
unnamed: C26.1, Q4.D, U18.1 (VDD)
VDD_A_3V3: Q4.S; also elsewhere on the board
