toasterllc/MDCBoard/MDCBoard.brd

## EAGLE design MDCBoard.brd (continued)

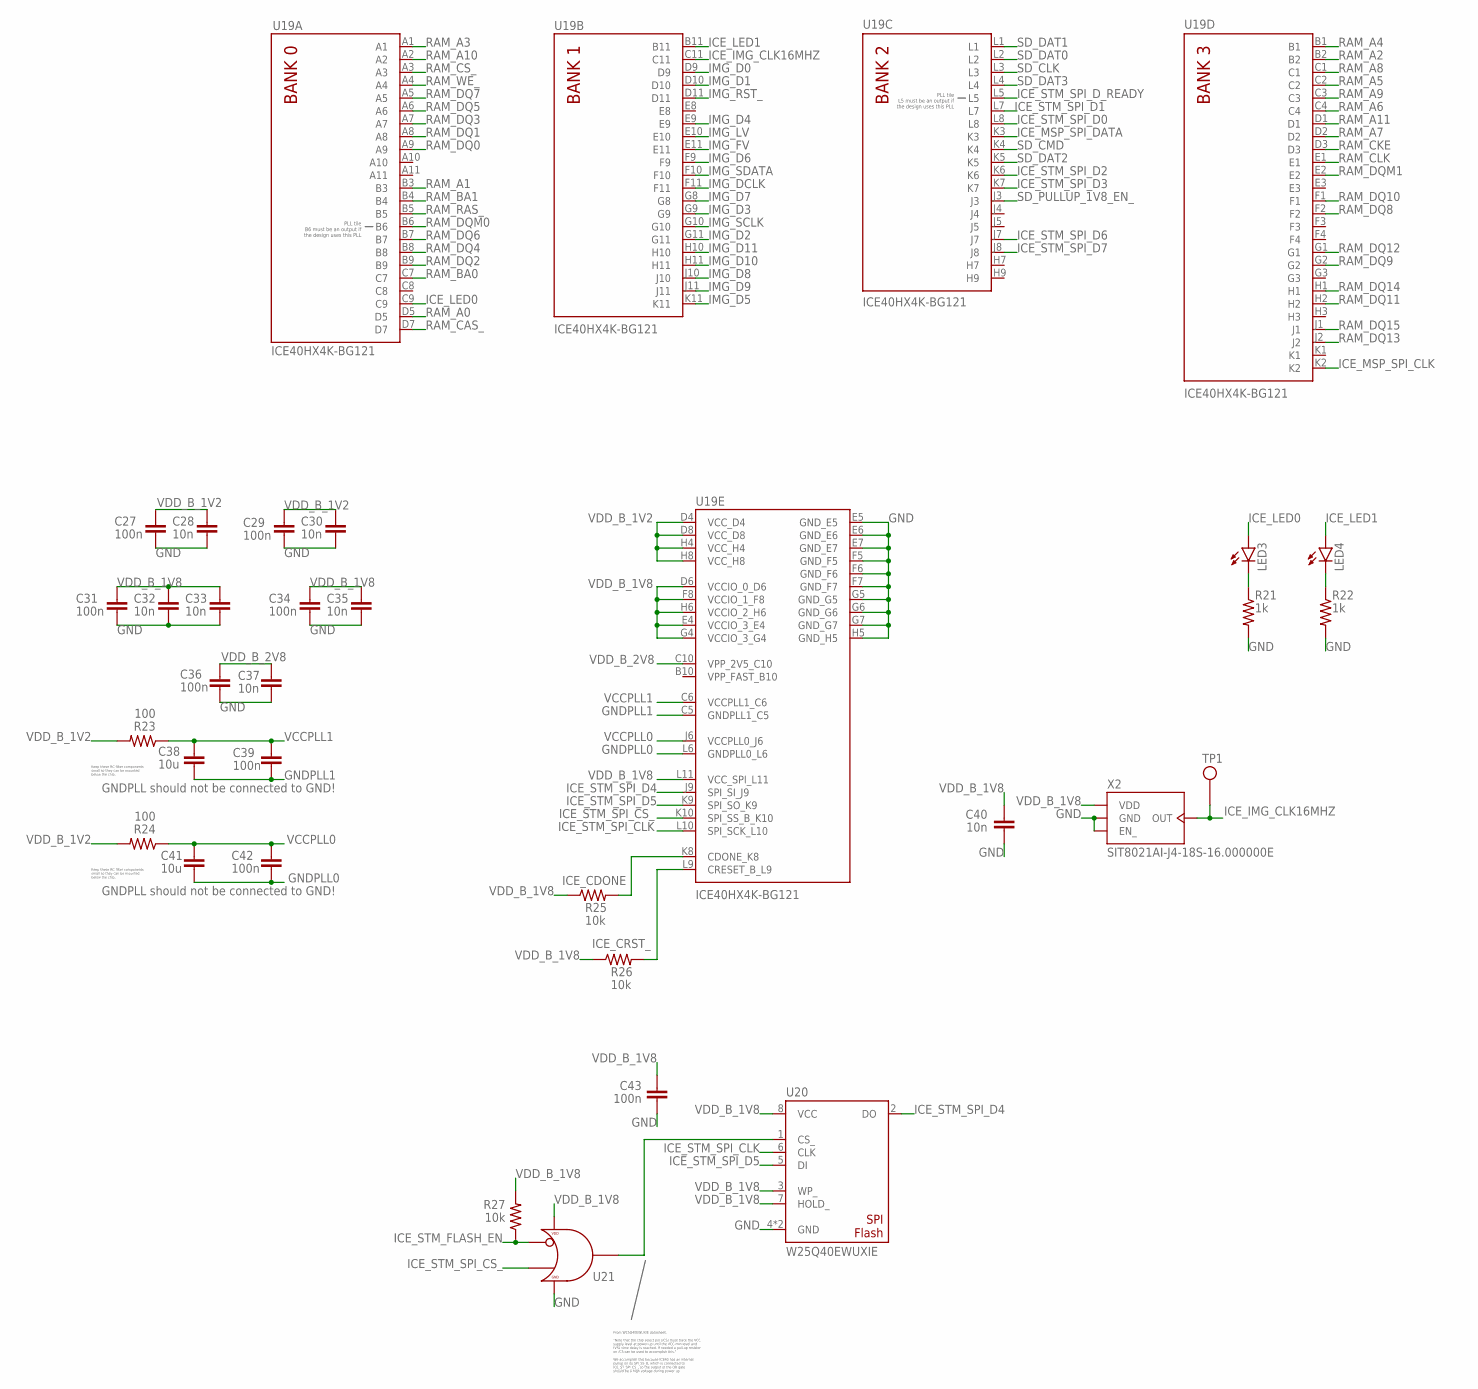
[picture p25: schematic MDCBoard.sch, sheet 6, ICE]

Parts:
C27, C29, C31, C34, C36, C39, C42, C43: 100n; 0402
C28, C30, C32, C33, C35, C37, C40: 10n; 0402
C38, C41: 10u; 0805
LED3, LED4: LEDLED-0603; LED-0603
R21, R22: 1k; 0402
R23, R24: 100; 0402
R25, R26, R27: 10k; 0402
TP1: TEST-POINT
U19: LATTICE-ICE40HX4K-BG121
U20: WINBOND-W25Q40EW; WINBOND-W25Q40EWUXIE
U21: NEXPERIA-74LVC1G98-OR-INV-INPUT; NEXPERIA-SOT363
X2: SITIME-SIT8021

Connections:
GND: C27.2, C28.2, C29.2, C30.2, C31.2, C32.2, C33.2, C34.2, C35.2, C36.2, C37.2, C40.2, C43.2, R21.2, R22.2, U19.E5 (GND_E5), U19.E6 (GND_E6), U19.E7 (GND_E7), U19.F5 (GND_F5), U19.F6 (GND_F6), U19.F7 (GND_F7), U19.G5 (GND_G5), U19.G6 (GND_G6), U19.G7 (GND_G7), U19.H5 (GND_H5), U20.4 (GND), U20.9 (GND), U21.2 (GND), U21.3 (GND), X2.1 (EN_), X2.4 (GND); also elsewhere on the board
GNDPLL0: C41.2, C42.2, U19.L6 (GNDPLL0_L6)
GNDPLL1: C38.2, C39.2, U19.C5 (GNDPLL1_C5)
ICE_CDONE: R25.2, U19.K8 (CDONE_K8); also elsewhere on the board
ICE_CRST_: R26.2, U19.L9 (CRESET_B_L9); also elsewhere on the board
ICE_IMG_CLK16MHZ: TP1.X, U19.C11, X2.2 (OUT); also elsewhere on the board
ICE_LED0: LED3.A, U19.C9
ICE_LED1: LED4.A, U19.B11
ICE_MSP_SPI_CLK: U19.K2; also elsewhere on the board
ICE_MSP_SPI_DATA: U19.K3; also elsewhere on the board
ICE_STM_FLASH_EN: R27.1, U21.1 (IN1); also elsewhere on the board
ICE_STM_SPI_CLK: U19.L10 (SPI_SCK_L10), U20.6 (CLK); also elsewhere on the board
ICE_STM_SPI_CS_: U19.K10 (SPI_SS_B_K10), U21.6 (IN2); also elsewhere on the board
ICE_STM_SPI_D0: U19.L8; also elsewhere on the board
ICE_STM_SPI_D1: U19.L7; also elsewhere on the board
ICE_STM_SPI_D2: U19.K6; also elsewhere on the board
ICE_STM_SPI_D3: U19.K7; also elsewhere on the board
ICE_STM_SPI_D4: U19.J9 (SPI_SI_J9), U20.2 (DO); also elsewhere on the board
ICE_STM_SPI_D5: U19.K9 (SPI_SO_K9), U20.5 (DI); also elsewhere on the board
ICE_STM_SPI_D6: U19.J7; also elsewhere on the board
ICE_STM_SPI_D7: U19.J8; also elsewhere on the board
ICE_STM_SPI_D_READY: U19.L5; also elsewhere on the board
IMG_D0: U19.D9; also elsewhere on the board
IMG_D1: U19.D10; also elsewhere on the board
IMG_D2: U19.G11; also elsewhere on the board
IMG_D3: U19.G9; also elsewhere on the board
IMG_D4: U19.E9; also elsewhere on the board
IMG_D5: U19.K11; also elsewhere on the board
IMG_D6: U19.F9; also elsewhere on the board
IMG_D7: U19.G8; also elsewhere on the board
IMG_D8: U19.J10; also elsewhere on the board
IMG_D9: U19.J11; also elsewhere on the board
IMG_D10: U19.H11; also elsewhere on the board
IMG_D11: U19.H10; also elsewhere on the board
IMG_DCLK: U19.F11; also elsewhere on the board
IMG_FV: U19.E11; also elsewhere on the board
IMG_LV: U19.E10; also elsewhere on the board
IMG_RST_: U19.D11; also elsewhere on the board
IMG_SCLK: U19.G10; also elsewhere on the board
IMG_SDATA: U19.F10; also elsewhere on the board
unnamed: LED3.C, R21.1
unnamed: LED4.C, R22.1
unnamed: U20.1 (CS_), U21.4 (OUT)
RAM_A0: U19.D5; also elsewhere on the board
RAM_A1: U19.B3; also elsewhere on the board
RAM_A2: U19.B2; also elsewhere on the board
RAM_A3: U19.A1; also elsewhere on the board
RAM_A4: U19.B1; also elsewhere on the board
RAM_A5: U19.C2; also elsewhere on the board
RAM_A6: U19.C4; also elsewhere on the board
RAM_A7: U19.D2; also elsewhere on the board
RAM_A8: U19.C1; also elsewhere on the board
RAM_A9: U19.C3; also elsewhere on the board
RAM_A10: U19.A2; also elsewhere on the board
RAM_A11: U19.D1; also elsewhere on the board
RAM_BA0: U19.C7; also elsewhere on the board
RAM_BA1: U19.B4; also elsewhere on the board
RAM_CAS_: U19.D7; also elsewhere on the board
RAM_CKE: U19.D3; also elsewhere on the board
RAM_CLK: U19.E1; also elsewhere on the board
RAM_CS_: U19.A3; also elsewhere on the board
RAM_DQ0: U19.A9; also elsewhere on the board
RAM_DQ1: U19.A8; also elsewhere on the board
RAM_DQ2: U19.B9; also elsewhere on the board
RAM_DQ3: U19.A7; also elsewhere on the board
RAM_DQ4: U19.B8; also elsewhere on the board
RAM_DQ5: U19.A6; also elsewhere on the board
RAM_DQ6: U19.B7; also elsewhere on the board
RAM_DQ7: U19.A5; also elsewhere on the board
RAM_DQ8: U19.F2; also elsewhere on the board
RAM_DQ9: U19.G2; also elsewhere on the board
RAM_DQ10: U19.F1; also elsewhere on the board
RAM_DQ11: U19.H2; also elsewhere on the board
RAM_DQ12: U19.G1; also elsewhere on the board
RAM_DQ13: U19.J2; also elsewhere on the board
RAM_DQ14: U19.H1; also elsewhere on the board
RAM_DQ15: U19.J1; also elsewhere on the board
RAM_DQM0: U19.B6; also elsewhere on the board
RAM_DQM1: U19.E2; also elsewhere on the board
RAM_RAS_: U19.B5; also elsewhere on the board
RAM_WE_: U19.A4; also elsewhere on the board
SD_CLK: U19.L3; also elsewhere on the board
SD_CMD: U19.K4; also elsewhere on the board
SD_DAT0: U19.L2; also elsewhere on the board
SD_DAT1: U19.L1; also elsewhere on the board
SD_DAT2: U19.K5; also elsewhere on the board
SD_DAT3: U19.L4; also elsewhere on the board
SD_PULLUP_1V8_EN_: U19.J3; also elsewhere on the board
VCCPLL0: C41.1, C42.1, R24.1, U19.J6 (VCCPLL0_J6)
VCCPLL1: C38.1, C39.1, R23.1, U19.C6 (VCCPLL1_C6)
VDD_B_1V2: C27.1, C28.1, C29.1, C30.1, R23.2, R24.2, U19.D4 (VCC_D4), U19.D8 (VCC_D8), U19.H4 (VCC_H4), U19.H8 (VCC_H8); also elsewhere on the board
VDD_B_1V8: C31.1, C32.1, C33.1, C34.1, C35.1, C40.1, C43.1, R25.1, R26.1, R27.2, U19.D6 (VCCIO_0_D6), U19.E4 (VCCIO_3_E4), U19.F8 (VCCIO_1_F8), U19.G4 (VCCIO_3_G4), U19.H6 (VCCIO_2_H6), U19.L11 (VCC_SPI_L11), U20.3 (WP_), U20.7 (HOLD_), U20.8 (VCC), U21.5 (VDD), X2.3 (VDD); also elsewhere on the board
VDD_B_2V8: C36.1, C37.1, U19.C10 (VPP_2V5_C10); also elsewhere on the board

Notes on the sheet:
GNDPLL should not be connected to GND!
Keep these RC filter components small so they can be mounted below the chip.
From W25Q40EWUXIE datasheet: "Note that the chip select pin (/CS) must track the VCC supply level at power-up until the VCC-min level and tVSL time delay is reached. If needed a pull-up resister on /CS can be used to accomplish this." We accomplish this because ICE40 has an internal pullup on its S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

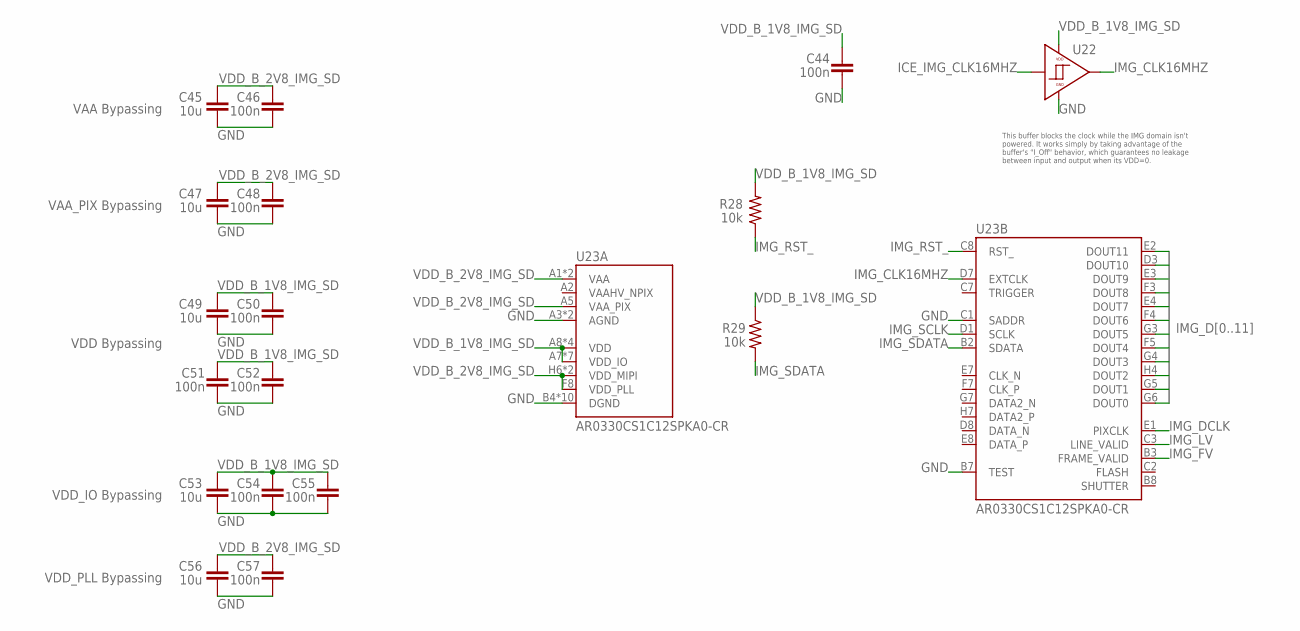
[picture p26: schematic MDCBoard.sch, sheet 7, IMG]

Parts:
C44, C46, C48, C50, C51, C52, C54, C55, C57: 100n; 0402
C45, C47, C49, C53, C56: 10u; 0805
R28, R29: 10k; 0402
U22: NEXPERIA-74LVC1G98-BUFFER; NEXPERIA-SOT363
U23: ON-AR0330CS1C12SPKA0

Connections:
GND: C44.2, C45.2, C46.2, C47.2, C48.2, C49.2, C50.2, C51.2, C52.2, C53.2, C54.2, C55.2, C56.2, C57.2, U22.2 (GND), U22.3 (GND), U23.A3 (AGND), U23.B4 (DGND), U23.B5 (AGND), U23.B6 (DGND), U23.B7 (TEST), U23.C1 (SADDR), U23.C4 (DGND), U23.C5 (DGND), U23.C6 (DGND), U23.D4 (DGND), U23.E6 (DGND), U23.G1 (DGND), U23.H2 (DGND), U23.H3 (DGND); also elsewhere on the board
ICE_IMG_CLK16MHZ: U22.6 (IN); also elsewhere on the board
IMG_CLK16MHZ: U22.4 (OUT), U23.D7 (EXTCLK)
IMG_D0: U23.G6 (DOUT0); also elsewhere on the board
IMG_D1: U23.G5 (DOUT1); also elsewhere on the board
IMG_D2: U23.H4 (DOUT2); also elsewhere on the board
IMG_D3: U23.G4 (DOUT3); also elsewhere on the board
IMG_D4: U23.F5 (DOUT4); also elsewhere on the board
IMG_D5: U23.G3 (DOUT5); also elsewhere on the board
IMG_D6: U23.F4 (DOUT6); also elsewhere on the board
IMG_D7: U23.E4 (DOUT7); also elsewhere on the board
IMG_D8: U23.F3 (DOUT8); also elsewhere on the board
IMG_D9: U23.E3 (DOUT9); also elsewhere on the board
IMG_D10: U23.D3 (DOUT10); also elsewhere on the board
IMG_D11: U23.E2 (DOUT11); also elsewhere on the board
IMG_DCLK: U23.E1 (PIXCLK); also elsewhere on the board
IMG_FV: U23.B3 (FRAME_VALID); also elsewhere on the board
IMG_LV: U23.C3 (LINE_VALID); also elsewhere on the board
IMG_RST_: R28.1, U23.C8 (RST_); also elsewhere on the board
IMG_SCLK: U23.D1 (SCLK); also elsewhere on the board
IMG_SDATA: R29.2, U23.B2 (SDATA); also elsewhere on the board
VDD_B_1V8_IMG_SD: C44.1, C49.1, C50.1, C51.1, C52.1, C53.1, C54.1, C55.1, R28.2, R29.1, U22.1 (VDD), U22.5 (VDD), U23.A7 (VDD_IO), U23.A8 (VDD), U23.B1 (VDD), U23.D2 (VDD_IO), U23.D5 (VDD_IO), U23.D6 (VDD_IO), U23.E5 (VDD_IO), U23.F6 (VDD_IO), U23.G2 (VDD), U23.G8 (VDD), U23.H5 (VDD_IO); also elsewhere on the board
VDD_B_2V8_IMG_SD: C45.1, C46.1, C47.1, C48.1, C56.1, C57.1, U23.A1 (VAA), U23.A5 (VAA_PIX), U23.A6 (VAA), U23.F8 (VDD_PLL), U23.H6 (VDD_MIPI), U23.H8 (VDD_MIPI); also elsewhere on the board

Notes on the sheet:
VAA Bypassing
VAA_PIX Bypassing
VDD Bypassing
VDD_IO Bypassing
VDD_PLL Bypassing
This buffer blocks the clock while the IMG domain isn't powered. It works simply by taking advantage of the buffer's "I_Off" behavior, which guarantees no leakage between input and output when its VDD=0.

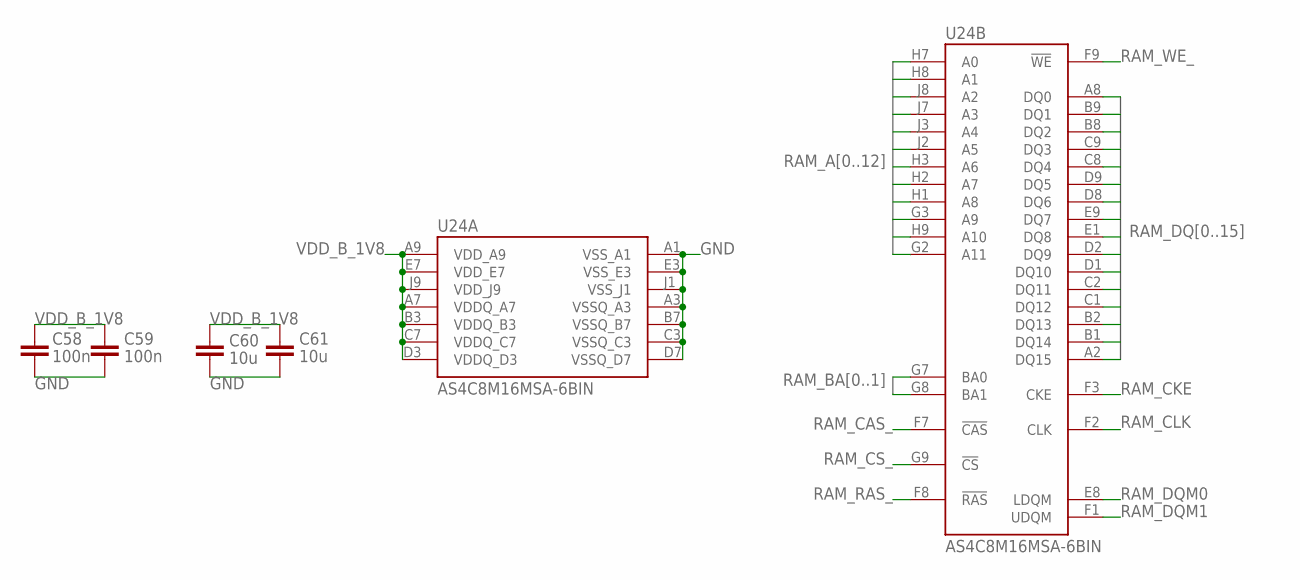
[picture p27: schematic MDCBoard.sch, sheet 8, RAM]

Parts:
C58, C59: 100n; 0402
C60, C61: 10u; 0805
U24: ALLIANCE-AS4C8M16MSA-6BIN

Connections:
GND: C58.2, C59.2, C60.2, C61.2, U24.A1 (VSS_A1), U24.A3 (VSSQ_A3), U24.B7 (VSSQ_B7), U24.C3 (VSSQ_C3), U24.D7 (VSSQ_D7), U24.E3 (VSS_E3), U24.J1 (VSS_J1); also elsewhere on the board
RAM_A0: U24.H7 (A0); also elsewhere on the board
RAM_A1: U24.H8 (A1); also elsewhere on the board
RAM_A2: U24.J8 (A2); also elsewhere on the board
RAM_A3: U24.J7 (A3); also elsewhere on the board
RAM_A4: U24.J3 (A4); also elsewhere on the board
RAM_A5: U24.J2 (A5); also elsewhere on the board
RAM_A6: U24.H3 (A6); also elsewhere on the board
RAM_A7: U24.H2 (A7); also elsewhere on the board
RAM_A8: U24.H1 (A8); also elsewhere on the board
RAM_A9: U24.G3 (A9); also elsewhere on the board
RAM_A10: U24.H9 (A10); also elsewhere on the board
RAM_A11: U24.G2 (A11); also elsewhere on the board
RAM_BA0: U24.G7 (BA0); also elsewhere on the board
RAM_BA1: U24.G8 (BA1); also elsewhere on the board
RAM_CAS_: U24.F7 (!CAS!); also elsewhere on the board
RAM_CKE: U24.F3 (CKE); also elsewhere on the board
RAM_CLK: U24.F2 (CLK); also elsewhere on the board
RAM_CS_: U24.G9 (!CS!); also elsewhere on the board
RAM_DQ0: U24.A8 (DQ0); also elsewhere on the board
RAM_DQ1: U24.B9 (DQ1); also elsewhere on the board
RAM_DQ2: U24.B8 (DQ2); also elsewhere on the board
RAM_DQ3: U24.C9 (DQ3); also elsewhere on the board
RAM_DQ4: U24.C8 (DQ4); also elsewhere on the board
RAM_DQ5: U24.D9 (DQ5); also elsewhere on the board
RAM_DQ6: U24.D8 (DQ6); also elsewhere on the board
RAM_DQ7: U24.E9 (DQ7); also elsewhere on the board
RAM_DQ8: U24.E1 (DQ8); also elsewhere on the board
RAM_DQ9: U24.D2 (DQ9); also elsewhere on the board
RAM_DQ10: U24.D1 (DQ10); also elsewhere on the board
RAM_DQ11: U24.C2 (DQ11); also elsewhere on the board
RAM_DQ12: U24.C1 (DQ12); also elsewhere on the board
RAM_DQ13: U24.B2 (DQ13); also elsewhere on the board
RAM_DQ14: U24.B1 (DQ14); also elsewhere on the board
RAM_DQ15: U24.A2 (DQ15); also elsewhere on the board
RAM_DQM0: U24.E8 (LDQM); also elsewhere on the board
RAM_DQM1: U24.F1 (UDQM); also elsewhere on the board
RAM_RAS_: U24.F8 (!RAS!); also elsewhere on the board
RAM_WE_: U24.F9 (!WE!); also elsewhere on the board
VDD_B_1V8: C58.1, C59.1, C60.1, C61.1, U24.A7 (VDDQ_A7), U24.A9 (VDD_A9), U24.B3 (VDDQ_B3), U24.C7 (VDDQ_C7), U24.D3 (VDDQ_D3), U24.E7 (VDD_E7), U24.J9 (VDD_J9); also elsewhere on the board

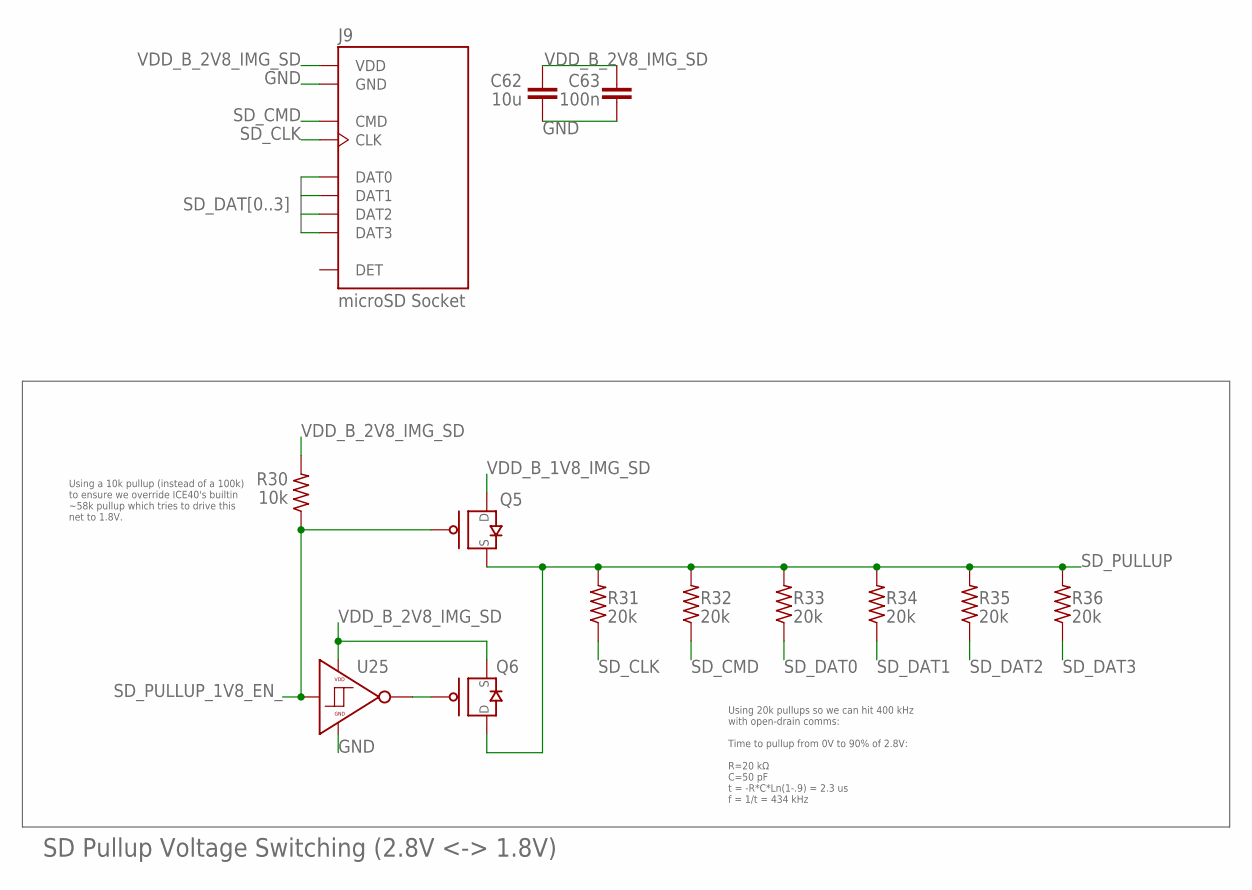
[picture p28: schematic MDCBoard.sch, sheet 9, SD]

Parts:
C62: 10u; 0805
C63: 100n; 0402
J9: MICROSD-SOCKET; MOLEX-1051620001
Q5, Q6: DIODESINC-DMG2305UX
R30: 10k; 0402
R31, R32, R33, R34, R35, R36: 20k; 0402
U25: NEXPERIA-74LVC1G98-INVERTER; NEXPERIA-SOT363

Connections:
GND: C62.2, C63.2, J9.GND1 (GND), J9.GND2 (GND), J9.GND3 (GND), J9.GND4 (GND), J9.VSS (GND), U25.2 (GND), U25.3 (GND), U25.6 (GND); also elsewhere on the board
unnamed: Q6.G, U25.4 (OUT)
SD_CLK: J9.CLK, R31.1; also elsewhere on the board
SD_CMD: J9.CMD, R32.1; also elsewhere on the board
SD_DAT0: J9.DAT0, R33.1; also elsewhere on the board
SD_DAT1: J9.DAT1, R34.1; also elsewhere on the board
SD_DAT2: J9.DAT2, R35.1; also elsewhere on the board
SD_DAT3: J9.DAT3, R36.1; also elsewhere on the board
SD_PULLUP: Q5.S, Q6.D, R31.2, R32.2, R33.2, R34.2, R35.2, R36.2
SD_PULLUP_1V8_EN_: Q5.G, R30.1, U25.1 (IN); also elsewhere on the board
VDD_B_1V8_IMG_SD: Q5.D; also elsewhere on the board
VDD_B_2V8_IMG_SD: C62.1, C63.1, J9.VDD, Q6.S, R30.2, U25.5 (VDD); also elsewhere on the board

Notes on the sheet:
Using a 10k pullup (instead of a 100k) to ensure we override ICE40's builtin ~58k pullup which tries to drive this net to 1.8V.
Using 20k pullups so we can hit 400 kHz with open-drain comms: Time to pullup from 0V to 90% of 2.8V: R=20 kΩ C=50 pF t = -R*C*Ln(1-.9) = 2.3 us f = 1/t = 434 kHz
SD Pullup Voltage Switching (2.8V <-> 1.8V)

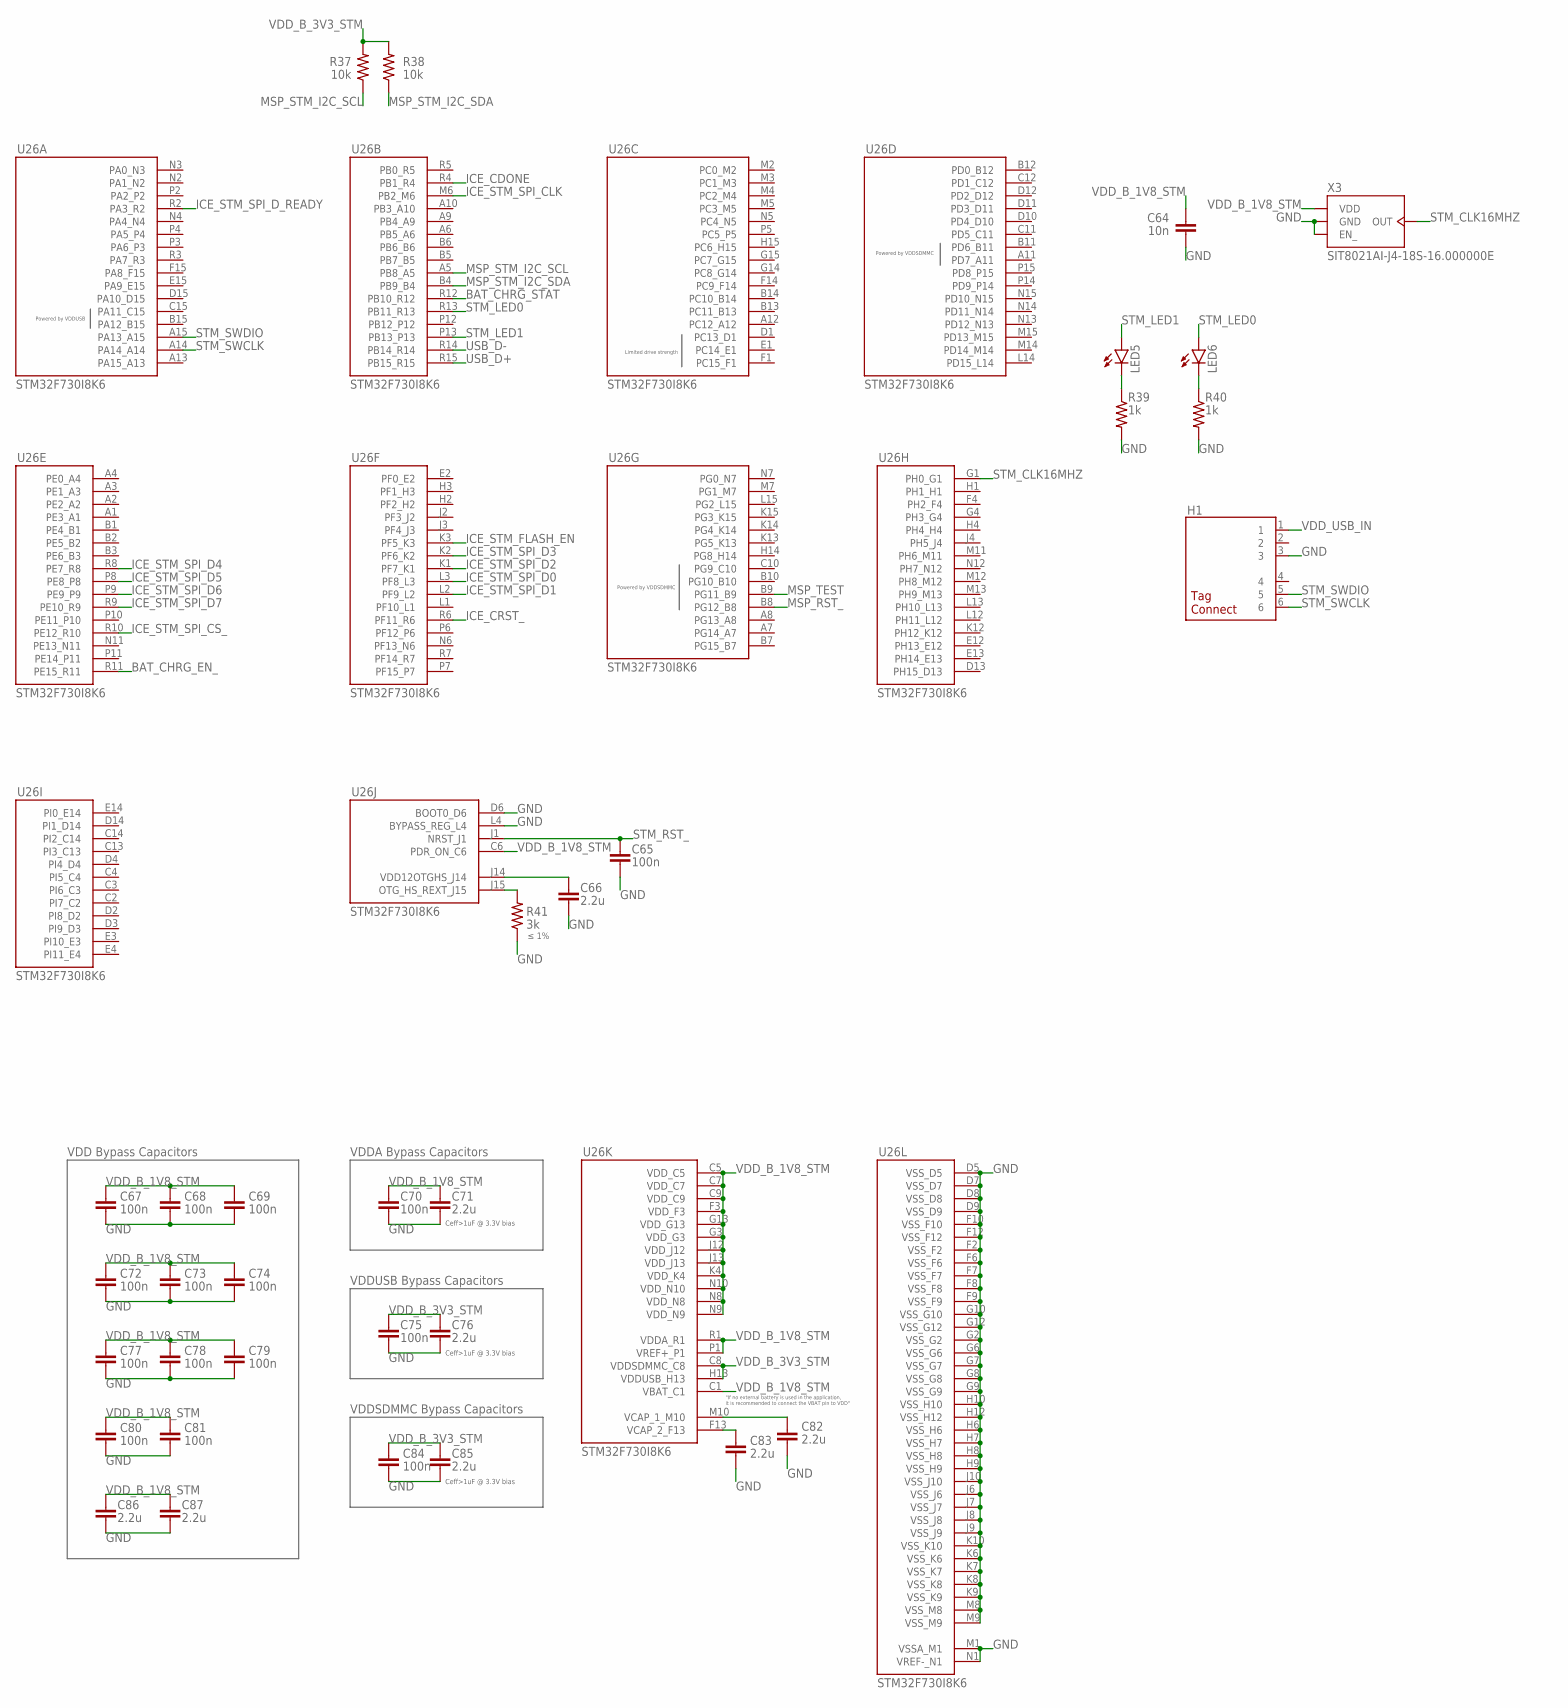
[picture p29: schematic MDCBoard.sch, sheet 10, STM]

Parts:
C64: 10n; 0402
C65, C67, C68, C69, C70, C72, C73, C74, C75, C77, C78, C79, C80, C81, C84: 100n; 0402
C66, C71, C76, C82, C83, C85, C86, C87: 2.2u; 0402
H1: TAGCONNECT-TC2030-NL
LED5, LED6: LEDLED-0603; LED-0603
R37, R38: 10k; 0402
R39, R40: 1k; 0402
R41: 3k; 0402
U26: STM-STM32F730; STM-STM32F730I8
X3: SITIME-SIT8021

Connections:
BAT_CHRG_EN_: U26.R11 (PE15_R11); also elsewhere on the board
BAT_CHRG_STAT: U26.R12 (PB10_R12); also elsewhere on the board
GND: C64.2, C65.2, C66.2, C67.2, C68.2, C69.2, C70.2, C71.2, C72.2, C73.2, C74.2, C75.2, C76.2, C77.2, C78.2, C79.2, C80.2, C81.2, C82.2, C83.2, C84.2, C85.2, C86.2, C87.2, H1.3, R39.2, R40.2, R41.1, U26.D5 (VSS_D5), U26.D6 (BOOT0_D6), U26.D7 (VSS_D7), U26.D8 (VSS_D8), U26.D9 (VSS_D9), U26.F2 (VSS_F2), U26.F6 (VSS_F6), U26.F7 (VSS_F7), U26.F8 (VSS_F8), U26.F9 (VSS_F9), U26.F10 (VSS_F10), U26.F12 (VSS_F12), U26.G2 (VSS_G2), U26.G6 (VSS_G6), U26.G7 (VSS_G7), U26.G8 (VSS_G8), U26.G9 (VSS_G9), U26.G10 (VSS_G10), U26.G12 (VSS_G12), U26.H6 (VSS_H6), U26.H7 (VSS_H7), U26.H8 (VSS_H8), U26.H9 (VSS_H9), U26.H10 (VSS_H10), U26.H12 (VSS_H12), U26.J6 (VSS_J6), U26.J7 (VSS_J7), U26.J8 (VSS_J8), U26.J9 (VSS_J9), U26.J10 (VSS_J10), U26.K6 (VSS_K6), U26.K7 (VSS_K7), U26.K8 (VSS_K8), U26.K9 (VSS_K9), U26.K10 (VSS_K10), U26.L4 (BYPASS_REG_L4), U26.M1 (VSSA_M1), U26.M8 (VSS_M8), U26.M9 (VSS_M9), U26.N1 (VREF-_N1), X3.1 (EN_), X3.4 (GND); also elsewhere on the board
ICE_CDONE: U26.R4 (PB1_R4); also elsewhere on the board
ICE_CRST_: U26.R6 (PF11_R6); also elsewhere on the board
ICE_STM_FLASH_EN: U26.K3 (PF5_K3); also elsewhere on the board
ICE_STM_SPI_CLK: U26.M6 (PB2_M6); also elsewhere on the board
ICE_STM_SPI_CS_: U26.R10 (PE12_R10); also elsewhere on the board
ICE_STM_SPI_D0: U26.L3 (PF8_L3); also elsewhere on the board
ICE_STM_SPI_D1: U26.L2 (PF9_L2); also elsewhere on the board
ICE_STM_SPI_D2: U26.K1 (PF7_K1); also elsewhere on the board
ICE_STM_SPI_D3: U26.K2 (PF6_K2); also elsewhere on the board
ICE_STM_SPI_D4: U26.R8 (PE7_R8); also elsewhere on the board
ICE_STM_SPI_D5: U26.P8 (PE8_P8); also elsewhere on the board
ICE_STM_SPI_D6: U26.P9 (PE9_P9); also elsewhere on the board
ICE_STM_SPI_D7: U26.R9 (PE10_R9); also elsewhere on the board
ICE_STM_SPI_D_READY: U26.R2 (PA3_R2); also elsewhere on the board
MSP_RST_: U26.B8 (PG12_B8); also elsewhere on the board
MSP_STM_I2C_SCL: R37.1, U26.A5 (PB8_A5); also elsewhere on the board
MSP_STM_I2C_SDA: R38.1, U26.B4 (PB9_B4); also elsewhere on the board
MSP_TEST: U26.B9 (PG11_B9); also elsewhere on the board
unnamed: C82.1, U26.M10 (VCAP_1_M10)
unnamed: C83.1, U26.F13 (VCAP_2_F13)
unnamed: R41.2, U26.J15 (OTG_HS_REXT_J15)
unnamed: C66.1, U26.J14 (VDD12OTGHS_J14)
unnamed: LED6.C, R40.1
unnamed: LED5.C, R39.1
STM_CLK16MHZ: U26.G1 (PH0_G1), X3.2 (OUT)
STM_LED0: LED6.A, U26.R13 (PB11_R13)
STM_LED1: LED5.A, U26.P13 (PB13_P13)
STM_RST_: C65.1, U26.J1 (NRST_J1)
STM_SWCLK: H1.6, U26.A14 (PA14_A14)
STM_SWDIO: H1.5, U26.A15 (PA13_A15)
USB_D+: U26.R15 (PB15_R15); also elsewhere on the board
USB_D-: U26.R14 (PB14_R14); also elsewhere on the board
VDD_B_1V8_STM: C64.1, C67.1, C68.1, C69.1, C70.1, C71.1, C72.1, C73.1, C74.1, C77.1, C78.1, C79.1, C80.1, C81.1, C86.1, C87.1, U26.C1 (VBAT_C1), U26.C5 (VDD_C5), U26.C6 (PDR_ON_C6), U26.C7 (VDD_C7), U26.C9 (VDD_C9), U26.F3 (VDD_F3), U26.G3 (VDD_G3), U26.G13 (VDD_G13), U26.J12 (VDD_J12), U26.J13 (VDD_J13), U26.K4 (VDD_K4), U26.N8 (VDD_N8), U26.N9 (VDD_N9), U26.N10 (VDD_N10), U26.P1 (VREF+_P1), U26.R1 (VDDA_R1), X3.3 (VDD); also elsewhere on the board
VDD_B_3V3_STM: C75.1, C76.1, C84.1, C85.1, R37.2, R38.2, U26.C8 (VDDSDMMC_C8), U26.H13 (VDDUSB_H13); also elsewhere on the board
VDD_USB_IN: H1.1; also elsewhere on the board

Notes on the sheet:
VDD Bypass Capacitors
VDDA Bypass Capacitors
VDDUSB Bypass Capacitors
≤ 1%
Ceff>1uF @ 3.3V bias
"If no external battery is used in the application, it is recommended to connect the VBAT pin to VDD"
VDDSDMMC Bypass Capacitors

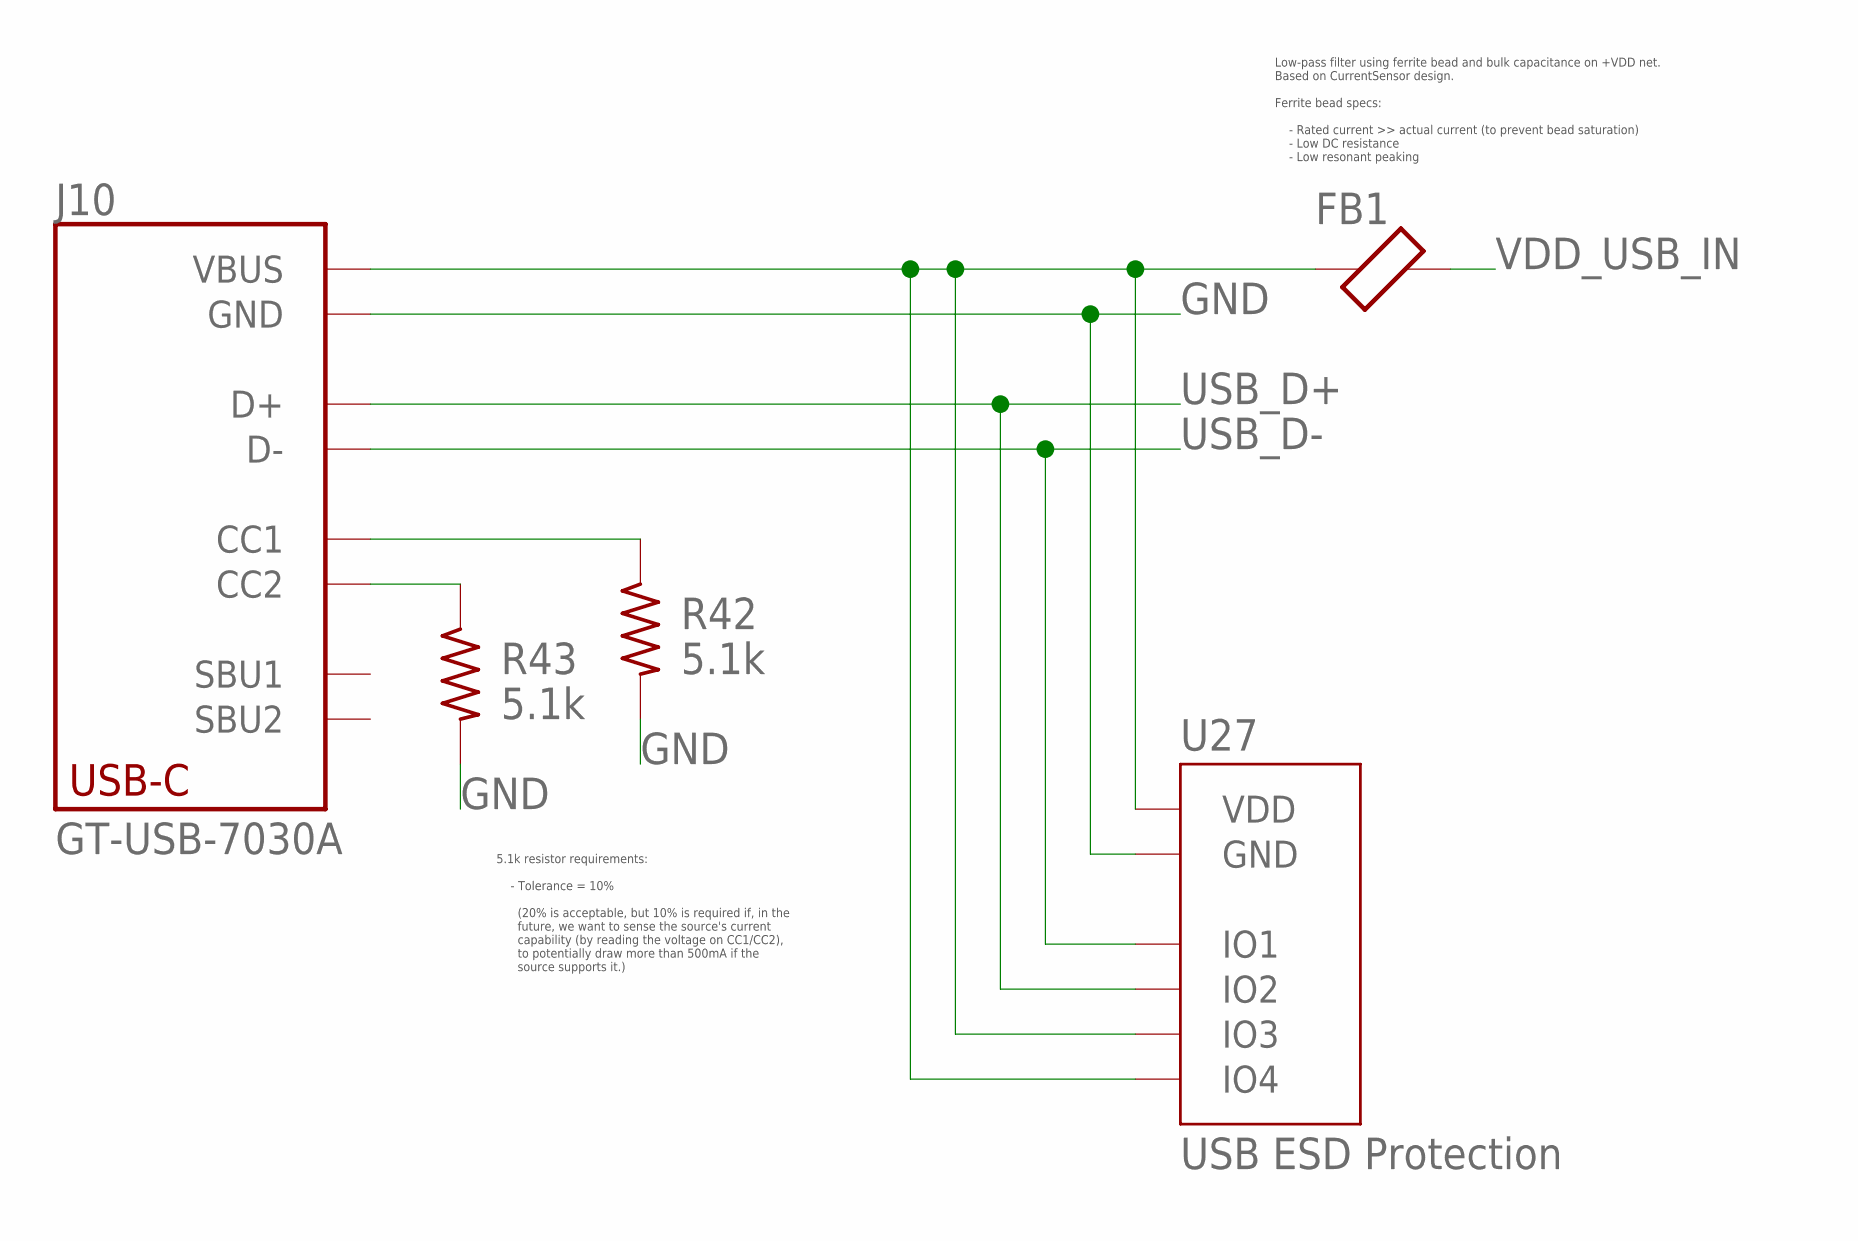
[picture p30: schematic MDCBoard.sch, sheet 11, USB]

Parts:
FB1: FERRITE-BEAD0402; 0402
J10: USB-C-RECEPTACLE-GSWITCH-7030A; GSWITCH-GT-USB-7030A
R42, R43: 5.1k; 0402
U27: DIODESINC-DT1446-04V-7

Connections:
GND: J10.A12B1 (GND), J10.B12A1 (GND), J10.GND1 (GND), J10.GND2 (GND), J10.GND3 (GND), J10.GND4 (GND), R42.2, R43.2, U27.2 (GND); also elsewhere on the board
unnamed: J10.A5 (CC1), R42.1
unnamed: J10.B5 (CC2), R43.1
unnamed: FB1.1, J10.A9B4 (VBUS), J10.B9A4 (VBUS), U27.4 (IO3), U27.5 (VDD), U27.6 (IO4)
USB_D+: J10.A6 (D+), J10.B6 (D+), U27.3 (IO2); also elsewhere on the board
USB_D-: J10.A7 (D-), J10.B7 (D-), U27.1 (IO1); also elsewhere on the board
VDD_USB_IN: FB1.2; also elsewhere on the board

Notes on the sheet:
Low-pass filter using ferrite bead and bulk capacitance on +VDD net. Based on CurrentSensor design. Ferrite bead specs: - Rated current >> actual current (to prevent bead saturation) - Low DC resistance - Low resonant peaking
5.1k resistor requirements: - Tolerance = 10% (20% is acceptable, but 10% is required if, in the future, we want to sense the source's current capability (by reading the voltage on CC1/CC2), to potentially draw more than 500mA if the source supports it.)

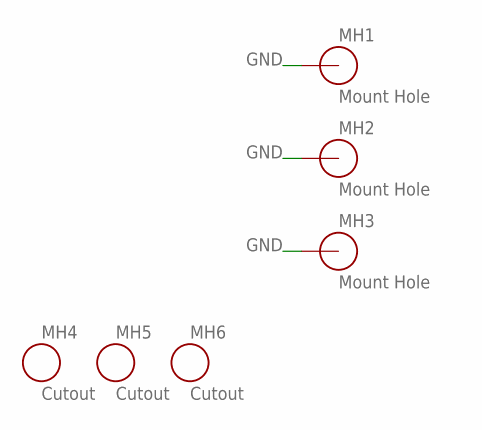
[picture p31: schematic MDCBoard.sch, sheet 12, MOUNTS]

Parts:
MH1, MH2, MH3: MDC-MOUNT-HOLE
MH4, MH5, MH6: MDC-CUTOUT-HALF

Connections:
GND: MH1.1, MH2.1, MH3.1; also elsewhere on the board

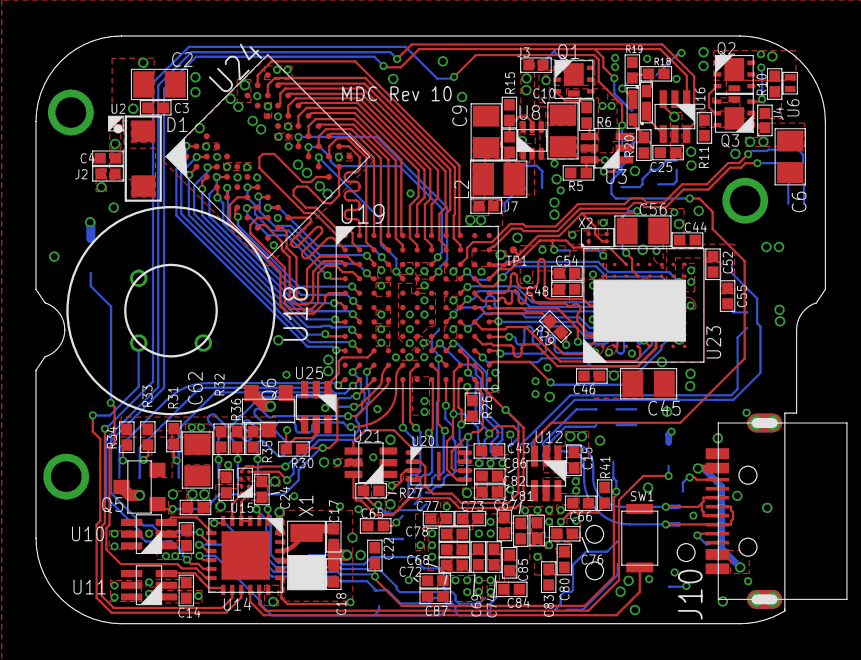
[picture p32: board MDCBoard.brd from above]

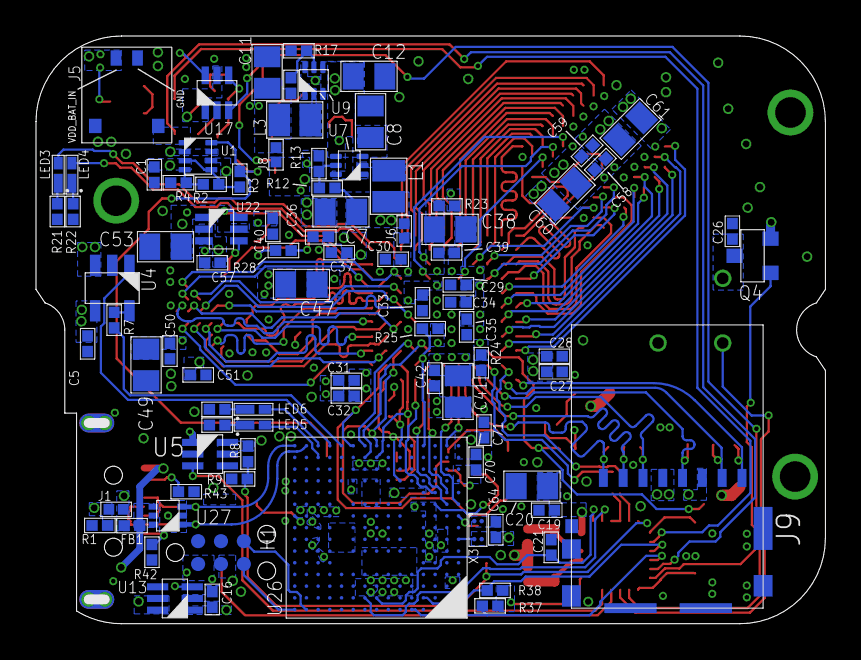
[picture p33: board MDCBoard.brd from below]

Board: 4 copper layers, 43.9 x 32.6 mm, 196 parts (90 on the bottom side), 168 nets.
