toasterllc/MDCBoard/(commit log)

2022-10-20 Add Rev6 files from MDC repo (board/Rev6 tag)
    [MDCBoard.brd, MDCBoard.sch]
2022-10-20 Rev6 updates from MDC repo
    [MDCBoard.brd, MDCBoard.sch]
2022-10-20 Rev7 updates:
    - Drive U5 (VDD_BAT voltage buffer) from an STM GPIO instead constantly while connected to USB
    - Battery voltage divider: change resistor values to take advantage of full ADC dynamic range
    [MDCBoard.brd, MDCBoard.sch]
2022-10-20 Stop using VDD_USB as a signal; use TPS2116DRLR's ST signal instead, pulled to VDD_USB via a 10k resistor
    [MDCBoard.brd, MDCBoard.sch]
2022-10-20 Swap ICE_STM_SPI nets so that ICERAMWrite can use QSPI to program, while ICEFlashWrite bitbangs
    [MDCBoard.brd, MDCBoard.sch]
2022-10-20 Add MDCBoard-Rev6 board/schematic for reference while we work on Rev7
    [MDCBoard-Rev6.brd, MDCBoard-Rev6.sch]
2022-10-23 Rev7 progress
    [MDCBoard.brd, MDCBoard.sch]
2022-10-26 Update comment
    [MDCBoard.sch]
2022-10-27 Update STM32 symbol
    [MDCBoard.sch]
2022-10-30 Replace NTB0102GF (U16) with TXB0102YZP, because TXB0102YZP is much easier to solder than NTB0102GF.
    NTB0102GF is a very small QFN and it's easy to short the pins together, whereas TXB0102YZP is a BGA.
    [MDCBoard.brd, MDCBoard.sch]
2022-11-02 Add LEDTest.brd
    [LEDTest.brd]
2022-11-02 Remove LEDTest.brd (use scratch/LEDTest branch)
    [LEDTest.brd]
2022-11-02 Route BAT_CHRG_LVL to MSP430
    [MDCBoard.brd, MDCBoard.sch]
2022-11-02 Add placeholder for LED flashing circuit (red+green)
    [MDCBoard.brd, MDCBoard.sch]
2022-11-03 Add power gate to motion sensor, so we can disable it if we don't need to detect motion
    [MDCBoard.brd, MDCBoard.sch]
2022-11-03 Add separate resistor for both LEDs that MSP430 will control
    [MDCBoard.brd, MDCBoard.sch]
2022-11-03 Layout progress
    [MDCBoard.brd, MDCBoard.sch]
2022-11-03 Update mounting hole size based on enclosure hole size (M1.6 screws, so made diameter 1.7mm)
    [MDCBoard.brd, MDCBoard.sch]
2022-11-03 Finished rough component placement
    [MDCBoard.brd]
2022-11-03 Finished fixing all the keepout DRC errors. 54 airwires to go.
    [MDCBoard.brd]
2022-11-03 47 airwires
    [MDCBoard.brd]
2022-11-03 44 airwires
    [MDCBoard.brd, MDCBoard.sch]
2022-11-04 41 airwires
    [MDCBoard.brd]
2022-11-04 Commit before moving Q1 subcircuit to be closer to U1
    [MDCBoard.brd]
2022-11-04 Done moving Q1 subcircuit to be closer to U1
    [MDCBoard.brd]
2022-11-04 36 airwires
    [MDCBoard.brd]
2022-11-04 34 airwires
    [MDCBoard.brd]
2022-11-04 33 airwires
    [MDCBoard.brd]
2022-11-04 31 airwires
    [MDCBoard.brd]
2022-11-04 30 airwires
    [MDCBoard.brd]
2022-11-04 28 airwires
    [MDCBoard.brd]
2022-11-04 25 airwires
    [MDCBoard.brd, MDCBoard.sch]
2022-11-04 22 airwires
    [MDCBoard.brd, MDCBoard.sch]
2022-11-04 21 airwires
    [MDCBoard.brd]
2022-11-04 20 airwires
    [MDCBoard.brd]
2022-11-04 17 airwires
    [MDCBoard.brd]
2022-11-04 16 airwires
    [MDCBoard.brd]
2022-11-04 15 airwires
    [MDCBoard.brd]
2022-11-04 14 airwires
    [MDCBoard.brd]
2022-11-04 13 airwires
    [MDCBoard.brd]
2022-11-04 12 airwires
    [MDCBoard.brd]
2022-11-04 11 airwires
    [MDCBoard.brd]
2022-11-04 10 airwires
    [MDCBoard.brd]
2022-11-04 9 airwires
    [MDCBoard.brd]
2022-11-04 8 airwires
    [MDCBoard.brd]
2022-11-04 7 airwires
    [MDCBoard.brd]
2022-11-04 6 airwires
    [MDCBoard.brd]
2022-11-04 5 airwires
    [MDCBoard.brd]
2022-11-04 4 airwires
    [MDCBoard.brd]
2022-11-04 0 airwires
    [MDCBoard.brd]
2022-11-04 Moved U21 so we have more space for the o-ring to expand
    [MDCBoard.brd]
2022-11-04 Make more space around lens mating circle
    [MDCBoard.brd]
2022-11-04 Move components further from lens mount ring
    [MDCBoard.brd]
2022-11-04 Underway replacing MSP430FR2422 -> MSP430FR2433 so we can have double the FRAM
    [MDCBoard.brd, MDCBoard.sch]
2022-11-05 Progress replacing MSP430FR2422 -> MSP430FR2433
    [MDCBoard.brd, MDCBoard.sch]
2022-11-05 0 airwires after replacing MSP430FR2422 -> MSP430FR2433
    [MDCBoard.brd, MDCBoard.sch]
2022-11-05 Length-matching progress
    [MDCBoard.brd]
2022-11-05 Move IMG_D0 to a different ICE40 pad to make the trace a little shorter
    [MDCBoard.brd, MDCBoard.sch]
2022-11-05 Length-match SD traces
    [MDCBoard.brd]
2022-11-05 Add ground vias
    [MDCBoard.brd]
2022-11-06 Underway moving motion sensor
    [MDCBoard.brd]
2022-11-06 Fixed DRC errors after moving motion sensor
    [MDCBoard.brd]
2022-11-07 Expanded motion sensor footprint to reflex max size based on datasheet tolerances. Fixed resulting DRC errors.
    [MDCBoard.brd, MDCBoard.sch]
2022-11-09 Replace flashing leds with new osram footprint
    [MDCBoard.brd, MDCBoard.sch]
2022-11-10 Update LED subcircuit based on testing results
    [MDCBoard.brd, MDCBoard.sch]
2022-11-10 3 airwires
    [MDCBoard.brd]
2022-11-10 2 airwires
    [MDCBoard.brd]
2022-11-10 Replace 50Ω resistor with 2x 100Ω resistors
    [MDCBoard.brd, MDCBoard.sch]
2022-11-10 Preparing to add button
    [MDCBoard.brd]
2022-11-10 - Added button - Routed BUTTON_SIGNAL_ to MSP - Updated bypass caps for STM's 3V3 signals
    [MDCBoard.brd, MDCBoard.sch]
2022-11-10 Reimplemented RAM routing
    [MDCBoard.brd]
2022-11-10 Adjust RAM routing
    * RAMClkTraceLen = 12.264 mm
    * ShortestRAMTraceLen = 7.387 mm (-4.877 mm)
    * LongestRAMTraceLen = 18.407 mm (+6.143 mm)
    * Vp [speed of signals in F4-4] = 0.1524 mm / ps
    * f [RAM frequency] = 108 MHz
    * TClkPeriod = 9.26 ns
    * Timing differences between shortest/longest trace and clock trace
    - TDiffShortest = (ShortestRAMTraceLen-RAMClkTraceLen) / Vp
    = -32 ps
    - TDiffLongest = (LongestRAMTraceLen-RAMClkTraceLen) / Vp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
    [MDCBoard.brd]
2022-11-11 Add keepout region for button stopper making contact with button
    [MDCBoard.brd]
2022-11-16 Add MDCBoard-Rev5.sch / MDCBoard-Rev5.brd for reference
    [MDCBoard-Rev5.brd, MDCBoard-Rev5.sch]
2022-11-17 Fix VDDA/VREF+ voltages -- apparently they need to be the same voltage as VDD (1.8V), but we increased them to 3.3V. Yikes.
    [MDCBoard.brd, MDCBoard.sch]
2022-11-17 Add additional STM32 via
    [MDCBoard.brd]
2022-11-18 Lower VDD_BAT voltage divider resistance so we get better readings with MSP430 / STM32
    [MDCBoard.brd, MDCBoard.sch]
2022-11-18 Add part numbers to 100 ohm resistors
    [MDCBoard.brd, MDCBoard.sch]
2022-11-18 Switch VDD_B MOSFET gate resistor from 10k -> 365k to reduce VDD_BAT droop when enabling VDD_B
    [MDCBoard.brd, MDCBoard.sch]
2022-11-18 Add part number to button
    [MDCBoard.brd, MDCBoard.sch]
2022-11-21 Correct size of a single via to be 10mil
    [MDCBoard.brd]
2022-11-21 Correct button part number
    [MDCBoard.brd, MDCBoard.sch]
2022-11-21 Fix Q3 copper pour for drain net
    [MDCBoard.brd]
2022-11-21 Update pad-to-pad clearance to 6mil, per NextPCB spec:
    SMD pad to SMD pad clearance(Pad without hole, different nets): ≥0.15mm
    [MDCBoard.brd]
2022-11-21 Fix pad-to-pad clearance DRC errors
    [MDCBoard.brd, MDCBoard.sch]
2022-11-21 Update pad-to-wire clearance to 6mil, purely to be consistent with the updated pad-to-pad clearance (6mil), and to make our DRC rules more conservative so that our design works with more PCB fabs.
    Fixed ~200 DRC errors that resulted
    [MDCBoard.brd]
2022-11-21 Fix more DRC errors from pad-to-wire clearance change
    [MDCBoard.brd, MDCBoard.sch]
2022-11-21 Update wire-to-via clearance to 6mil, purely to be consistent with the updated pad-to-pad clearance (6mil), and to make our DRC rules more conservative so that our design works with more PCB fabs.
    In the process of fixing resulting DRC errors (~300)
    [MDCBoard.brd]
2022-11-21 Fixing clearance DRC errors (139 left)
    [MDCBoard.brd]
2022-11-21 Fixing clearance DRC errors (96 left)
    [MDCBoard.brd]
2022-11-21 Fixing clearance DRC errors (56 left)
    [MDCBoard.brd]
2022-11-21 Fixing clearance DRC errors (5 left)
    [MDCBoard.brd]
2022-11-21 Fixing clearance DRC errors (0 left)
    [MDCBoard.brd]
2022-11-21 Fixed dimension DRC errors
    [MDCBoard.brd]
2022-11-21 Update via-to-via clearance to 6mil, purely to be consistent with the updated pad-to-pad clearance (6mil), and to make our DRC rules more conservative so that our design works with more PCB fabs.
    Fixed all resulting DRC errors.
    [MDCBoard.brd]
2022-11-21 Length-match SD nets
    [MDCBoard.brd]
2022-11-23 Fix GND via nets
    [MDCBoard.brd]
2022-11-23 Changed Copper-Dimension DRC distance 15mil -> 16mil
    Fixed dimension DRC errors. Had to move one of the mount points slightly inward, so we'll need to update MDCEnclosure.
    [MDCBoard.brd]
2022-11-23 Small adjustment to see if we can fix a NextDFM error
    [MDCBoard.brd]
2022-11-24 Expand a polygon to connect several close regions
    [MDCBoard.brd]
2022-11-24 Cleanup GND polygons around USB-C receptacle
    [MDCBoard.brd]
2022-11-24 Renumber parts
    [MDCBoard.brd, MDCBoard.sch]
2022-11-24 Cleaning up silkscreen
    [MDCBoard.brd]
2022-11-24 Fix 'wire stub' and 'angle' DRC errors after enabling them in the DRC panel
    [MDCBoard.brd]
2022-11-24 Update EagleLibrary and DRC rules
    [MDCBoard.brd]
2022-11-25 Update part numbers
    [MDCBoard.brd, MDCBoard.sch]
2022-11-25 Move wires/vias away from tactile switch underside, since it seems like there's exposed metal
    This commit is what we ordered from NextPCB:
    https://www.nextpcb.com/order/orderPacketDetail?group_id=199017&status=production
    [MDCBoard.brd, MDCBoard.sch]
2022-11-26 Change tactile switch part number to use a part with height=0.6mm (instead of 0.65mm), because 0.6mm is more common
    [MDCBoard.brd, MDCBoard.sch]
2022-11-30 Update EagleLibrary after fixing 0806 footprint
    [MDCBoard.brd, MDCBoard.sch]
2022-12-03 Remove STM nets, and prepare for adding MSP<->STM comms
    [MDCBoard.brd, MDCBoard.sch]
2022-12-03 Remove MSP_HOST_MODE_
    [MDCBoard.brd, MDCBoard.sch]
2022-12-03 Wired up MSP<->STM I2C comms, and added pullup resistors
    [MDCBoard.brd, MDCBoard.sch]
2022-12-04 Cleanup board
    [MDCBoard.brd]
2022-12-04 Expand MSP ground via
    [MDCBoard.brd]
2022-12-04 Rename LED_FLASH_X_ -> LED_X_
    [MDCBoard.brd, MDCBoard.sch]
2022-12-04 Switch battery voltage divider dynamic range to [0,3.3]V
    Now uses 1k-3k resistors
    [MDCBoard.brd, MDCBoard.sch]
2022-12-04 Replace battery connector with Molex 781710002, still need to layout
    [MDCBoard.brd, MDCBoard.sch]
2022-12-05 Fix DRC errors
    [MDCBoard.brd]
2022-12-05 Update part number of other 3k resistor to use the .1% version
    [MDCBoard.brd, MDCBoard.sch]
2022-12-05 Update resistor tolerance/part numbers. For the battery voltage divider, looks like we can use 0.5% resistors instead of 0.1%, and we'll get <=1.8% error due to the resistors.
    [MDCBoard.brd, MDCBoard.sch]
2022-12-05 Make solder jumper J1 more accessible so we can solder it easier
    [MDCBoard.brd]
2022-12-05 Improve power layer by expanding thin traces
    [MDCBoard.brd]
2022-12-05 Add more ground vias
    [MDCBoard.brd]
2022-12-05 Cleanup silkscreen
    [MDCBoard.brd]
2022-12-05 Update DRC rules to reduce solderpaste size for SMD pads
    [MDCBoard.brd]
2022-12-05 Update DRC rules to slightly increase solderpaste size for SMD pads
    [MDCBoard.brd]
2022-12-06 I2C updates:
    - Make MSP_STM_I2C_SDA / MSP_STM_I2C_SCL pullups powered by VDD_B_3V3_STM (instead of VDD_A_3V3)
    so that there's zero leakage into STM when STM is unpowered.
    - Wire VDD_B_3V3_STM to an MSP pin so MSP can easily detect STM powering up/down
    - This is necessary because we need initialize I2C when STM powers up, and exit host mode
    and turn off LEDs when STM powers down
    - Ideally the I2C UCCLTOIE ("clock low time-out") interrupt would let us detect STM turning
    off (and monitor MSP_STM_I2C_SDA / MSP_STM_I2C_SCL to detect STM power up), but UCCLTOIE
    only works in the middle of I2C transactions, so we can't use it to reliably detect STM
    turning off.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
    [MDCBoard.brd, MDCBoard.sch]
2022-12-06 Adjust power layer
    [MDCBoard.brd]
2022-12-06 Remove errant polygon from ground layer
    [MDCBoard.brd]
2022-12-06 This commit is what we ordered from NextPCB:
    https://www.nextpcb.com/order/orderPacketDetail?group_id=201925&status=production
    (There was an earlier Rev7 version that we decided not to assemble, because we realized
    that we want the LEDs to light up when plugging the device in, which required changes.
    Rather than create a Rev8, we're going to pretend the previous Rev7 never happened.)
2022-12-09 Add cream to MOLEX-781710002 pads so the cutouts are generated on a stencil
    [MDCBoard.brd, MDCBoard.sch]
2022-12-20 Add comment
    [MDCBoard.sch]
2022-12-21 Give names to MSP_XIN / MSP_XOUT nets
    [MDCBoard.brd, MDCBoard.sch]
2023-05-22 Replace LED drivers (Q4 and Q5) with 74LVC1G98GW,125 in the MUX configuration
    [MDCBoard.brd, MDCBoard.sch]
2023-05-22 Replace U5 with a TPS22919 load switch
    [MDCBoard.brd, MDCBoard.sch]
2023-05-22 Connect ground of R7 to a 5-V tolerant GPIO of STM32
    [MDCBoard.brd, MDCBoard.sch]
2023-05-22 - Switch ICE<->MSP level shifter to NXB0102UN (BGA)
    - Move C19 a bit further away from SD card holder
    [MDCBoard.brd, MDCBoard.sch]
2023-05-23 Finished with board cutouts, implemented using a circle+triangle on the milling layer
    [MDCBoard.brd]
2023-05-23 Update board mount point position
    [MDCBoard.brd]
2023-05-23 Update board cutout
    [MDCBoard.brd]
2023-05-24 Fixed all DRC errors
    [MDCBoard.brd]
2023-05-24 Rename LED nets after removing 4x LEDs
    [MDCBoard.brd, MDCBoard.sch]
2023-05-24 Add restrict layers for board cutouts. Fix resulting DRC errors.
    [MDCBoard.brd]
2023-05-24 Add part number
    [MDCBoard.brd, MDCBoard.sch]
2023-05-24 Move text
    [MDCBoard.sch]
2023-05-24 Replace solder jumpers with JUMPER-SOLDER-CLOSED
    [MDCBoard.brd, MDCBoard.sch]
2023-05-24 Replace cutouts with MDC-CUTOUT part from library
    [MDCBoard.brd, MDCBoard.sch]
2023-05-25 Update MDC-CUTOUT part so that dimension layer works properly
    [MDCBoard.brd, MDCBoard.sch]
2023-05-26 Update EagleLibrary
    [MDCBoard.sch]
2023-05-30 Replaced USB-C receptacle with waterproof one. Layout progress.
    [MDCBoard.brd, MDCBoard.sch]
2023-06-05 Fix most DRC errors, just dimension errors left which we may not be able to fix
    [MDCBoard.brd]
2023-06-05 Replace left board cutout with 2x cutout-half
    [MDCBoard.brd, MDCBoard.sch]
2023-06-05 Move TagConnect footprint so we can program STM32 without removing the board
    [MDCBoard.brd]
2023-06-05 TagConnect footprint progress
    [MDCBoard.brd]
2023-06-06 Adjust part labels
    [MDCBoard.brd, MDCBoard.sch]
2023-06-08 Progress moving mount point
    [MDCBoard.brd]
2023-06-08 Finished moving mount point
    [MDCBoard.brd]
2023-06-08 Round mount point position
    [MDCBoard.brd]
2023-06-09 Move silkscreen labels
    [MDCBoard.brd]
2023-06-09 Update board revision number
    [MDCBoard.brd]
2023-06-09 Add NextPCB-Order directory
    [MDCBoard.csv]
2023-06-09 Add PN2 to Q1/Q2/Q3
    [MDCBoard.brd, MDCBoard.sch]
2023-06-09 NextPCB-Order: filter parts from MDCBoard.mnb / MDCBoard.mnt that NextPCB won't be responsible for mounting
2023-06-10 NextPCB-Order progress
    [BOM.xlsx, MDCBoard.csv]
2023-06-10 Update MDC-CUTOUT prefix: X -> MH
    [MDCBoard.brd, MDCBoard.sch]
2023-06-10 Add assembly attributes to schematic+board devices. Needs some corrections.
    [MDCBoard.brd, MDCBoard.sch]
2023-06-10 Correct assembly attributes
    [MDCBoard.brd, MDCBoard.sch]
2023-06-10 AS-MOUNT-NEXTPCB -> AS-MOUNT-FAB
    [MDCBoard.brd, MDCBoard.sch]
2023-06-10 Update BOM
2023-06-10 Add MDCBoard.csv
    [MDCBoard.csv]
2023-06-10 Update NextPCB-Order
    [BOM.xlsx, MDCBoard.xlsx]
2023-06-11 Fix diode orientations to follow IPC-7351
    [MDCBoard.brd, MDCBoard.sch]
2023-06-11 Update part label positions
    [MDCBoard.brd]
2023-07-01 Switch TagConnect to 3-post version
    [MDCBoard.brd, MDCBoard.sch]
2023-07-01 Move right angle in board outline slightly further away from USB-C receptacle, to give a little more clearance between board and receptacle plastic
    [MDCBoard.brd, MDCBoard.sch]
2023-07-01 Move USB-C receptacle right angle a little more
    [MDCBoard.brd, MDCBoard.sch]
2023-07-03 Mount LED3,LED4,LED5,LED6 so we can debug board failures more easily
    [MDCBoard.brd, MDCBoard.sch]
2023-07-03 Update parts AS-MOUNT-FAB / AS-OUR-STOCK
    [MDCBoard.brd, MDCBoard.sch]
2023-07-03 U15 PN NXB0102UN -> NXB0102UNZ
    [MDCBoard.brd, MDCBoard.sch]
2023-07-04 Update AS-MOUNT-FAB / AS-OUR-STOCK for: J10, U24, U19, U26
    [MDCBoard.brd, MDCBoard.sch]
2023-07-04 Update revision text on board: Rev 9 -> Rev 10
    [MDCBoard.brd]
2023-07-04 Update board to get rid of airwires
    [MDCBoard.brd]
2023-07-04 Final board touches -- add additional ground vias
    [MDCBoard.brd]
2023-07-04 Update centroid code for NextPCB's expected format
    [MDCBoard-Centroid.csv]
2023-07-08 Add: NextPCB-Order/Part-Orientation-Symbols.sketch NextPCB-Order/MDCBoard-Solder-Paste-Illustration.sketch
2023-07-08 Add NextPCB-Order/BOM-Part-Orientations.numbers
2023-07-08 Add NextPCB-Order/Diodes-Orientation.sketch
2023-07-08 Update:
    NextPCB-Order/Additional-Parts-Needed.numbers
    NextPCB-Order/BOM-Part-Orientations.numbers
2023-07-13 Add NextPCB-Assembly-Packet.pdf
2023-09-01 Add red/green labels to LED1/LED2 in schematic
    [MDCBoard.brd, MDCBoard.sch]
2025-03-07 Add Schematic.pdf
